Tokoro0917/KOGUMA-Mk4/mechanical/sensor_holder/README.md

# 壁センサのホルダ(v4、2026-11-01)

発光(OPV332)と受光(SFH 229 FA)を入れて、**基板の裏(下)にさかさまに付ける**樹脂の部品。4個(FL・FR・L・R)。**ToraNeko.Mk3 のセンサホルダ v4 と同じ形**(`mechanical/exported/TORANEKO.Mk3_v36.step` の「センサホルダ v4」を CadQuery で読んで測った)。

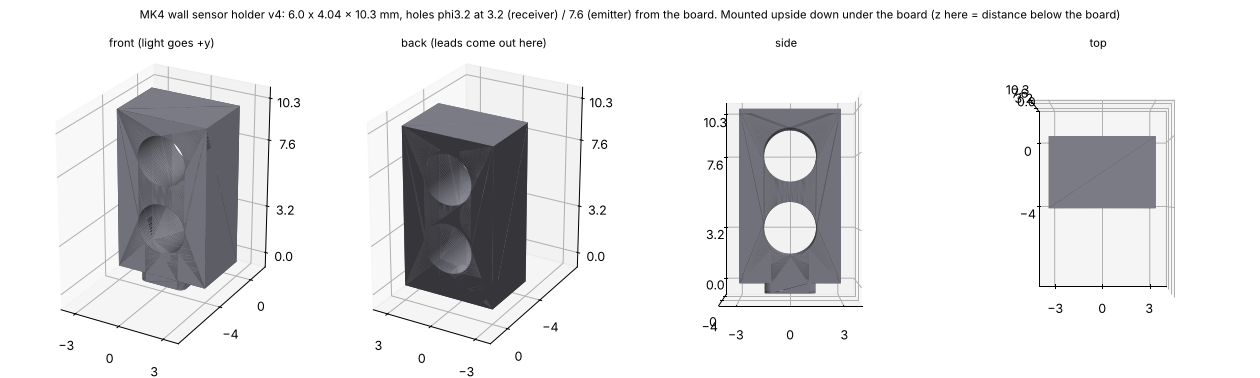
[picture p4: mechanical/sensor_holder/sensor_holder_v4.png]
センサのホルダ


図の z は基板の面からの距離(機体では下向き)。

| 項目 | 寸法 |
|---|---|
| 大きさ | 幅 6.0 × 奥行き 4.04 × 高さ 10.3mm(基板の下面 z 13.6 から下の端 z 3.3。フレームの上面 z 3.0 との 0.3mm に両面テープをはさんで当てる) |
| 下の端 | 平らな 6.0 × 4.04mm(24mm²)。緩衝材(両面テープ)を貼ってフレームに当てる(v4) |
| 穴 | φ3.2 を光の向きに貫通。**基板から 7.6mm(z 6.0)が発光 OPV332、3.2mm(z 10.4)が受光 SFH 229 FA**(どちらも φ3 の T-1)。ToraNeko と同じく、発光が基板から遠い穴 |
| 角 | すべて角(v4。v3 までは前の縦の辺 R1.6、前の端の辺 R1.6、端の横の辺 R1.0) |
| ほぞ | 3.0 × 3.0 × 0.6mm(基板の厚さ)、角 R0.4。後ろの面にそろえる。基板の穴は 3.2 × 3.2mm、角 R0.5 |
| 重さ | 190mm³、約0.22g(光造形の樹脂 1.15 g/cm³) |

**v4(2026-11-01)**: **後ろへ出す足をやめ、ホルダの形のまま、そのまま下まで伸ばす**(四角い柱 6.0 × 4.04 × 10.3mm)。**丸めていた角をすべて角にし**、下の端の面を全部平ら(6.0 × 4.04mm = 24mm²)にして、そこに**緩衝材(両面テープ、スポンジ)**を貼ってフレームに当てる。
- フレーム v6.9 は、この下の端の真下とまわり 1mm を窓のないカーボンにした(4つとも 24.2mm² がすべてカーボン)
- 発光・受光の足、基板のパッドの位置は v3 と同じ

**v3(2026-10-31)**: **下の端をフレームに当てる**。v2 はフレームとの間が 0.7mm で、フレームの前がたわむ(前の角に 1.5N で 0.56mm)と当たるおそれがあった。逆にフレームに当てて、基板の前の板をフレームで支える。
- 高さ 9.9 → 10.3mm(下の端 z 3.3)。フレームとの 0.3mm に**両面テープ(スポンジ)**をはさんで貼る。印刷の誤差(±0.2mm)を吸い、衝撃をやわらげる。光の高さ(穴の位置)は v2 と同じ
- 下の端から後ろへ足(3.5mm)を出す。横の2本は真下がほとんどフレームの窓なので、足で後ろの骨に当てる
- 基板の振動(`mechanical/vehicle/pcb_modes.py 0.6 holders`): 横の壁センサが揺れる振動は、v2(当てない)の 148Hz から、ホルダの所で固く支えるとなくなる(基板の一番低い振動は電池の下で 289Hz)。テープはやわらかいのでこれより下がるが、センサはフレームと一緒に動くようになる(フレームの1次は 262Hz)
- 基板を外すときは、テープをはがす
- フレームは v6.7 で、ホルダ(足を含む)の真下とまわり 1mm を窓のないカーボンにした(当てる所 45mm²)

**v2(2026-10-30)**: 基板の裏に付けることにしたので、ToraNeko と同じ高さ 10.5mm(穴 3.5・8.1mm)ではフレームまで 0.1mm しかない。高さを 9.9mm、穴を 3.2・7.6mm(穴の間の壁 1.2mm、端の壁 0.7mm)にした。v1 は基板の上に立てる ToraNeko と同じ寸法だった

機体(`mechanical/vehicle/vehicle.py`)で確かめた: ほかの部品とぶつからない(v3・v4 はフレームと 0.3mm で、そこに両面テープ)。光(前の面から 60mm、広がりを見て円すい)を遮る部品はない

- **光を通さない黒い樹脂**で作る(JLC3DP の光造形、**JLC Black Resin**。2026-10-31)。発光の光がホルダの中を通って受光に入らないようにする(ToraNeko の README:「LED からの光が隣の受光素子に直接入らないよう、センサホルダで遮光する」)
- 発光・受光は後ろから穴に差し、足を後ろの面で基板の側(上)に曲げて基板の穴に通し、基板の上の面ではんだ付けする。受光(下)の足は後ろの面の 0.85mm 後ろ、発光(上)の足は 3.0mm 後ろ(ToraNeko は 2.8mm。基板のパッドどうしを離すため少し後ろにした)。足のピッチは 2.54mm
- 穴の φ3.2 は ToraNeko と同じ。OPV332 の外径は販売店の資料で 3.18mm なので、きつければ φ3.2 のドリルでさらう。ゆるければ接着する
- 基板への付け方: ほぞを下から基板の穴に差して、足を上からはんだ付けする。ホルダは足でつり下がるので、基板の裏に接着もする
- 基板の側: フットプリント `KOGUMA-Mk4:WallSensor_Holder_Emitter`(ほぞの穴を Edge.Cuts で含む)と `WallSensor_Holder_Receiver` を、**裏の面に**、同じ位置・同じ向き(光の向き)に置く。位置は `mechanical/vehicle/pcb_shape.py` の `SENS`(ホルダの前の面の真ん中)

| ファイル | 中身 |
|---|---|
| `sensor_holder.py` | CadQuery のスクリプト。寸法は `P` |
| `sensor_holder_v3.step`・`.stl` | 注文用(単位 mm) |
| `sensor_holder_v4.png` | 図 |

作り直すには(このフォルダで): `python3 sensor_holder.py`
