Tokoro0917/KOGUMA-Mk4/docs/reference/README.md

# 参考資料

| ファイル | 中身 |
|---|---|
| `KOGUMA-CHAN.MkII_v2.pdf` | MK3(KOGUMA MkIIl)の回路図(KiCad、A3、1枚)。MK4 の資料で「MK3 と同じ」と書いた回路(壁センサ、電源スイッチ、ファン、LED、ブザー、スイッチ、発振子など)の元 |
