Tokoro0917/KOGUMA-Mk4/hardware/kicad/KOGUMA-Mk4_Encoder/README.md

# KOGUMA-Mk4_Encoder(エンコーダの基板)

KiCad 9.0 で開く(`KOGUMA-Mk4_Encoder.kicad_pro`)。左右で同じ基板を2枚使う。

| ファイル | 中身 |
|---|---|
| `KOGUMA-Mk4_Encoder.kicad_sch` | 回路図: MT6835、C1(0.1µF)、J1(メイン基板へのパッド7つ) |
| `KOGUMA-Mk4_Encoder.kicad_pcb` | 基板: 5.3 × 12.3 × 0.6mm、2層。MT6835 はチップの面(F)、C1 は裏の面(B) |
| `KOGUMA-Mk4_Encoder.kicad_sym` | MT6835 の記号(KiCad の標準ライブラリにないので作った。ピンはデータシート Rev.1.3 の表) |
| `KOGUMA-Mk4_Encoder.pretty/ENC_Edge` | 基板の上の辺のパッド。`Dwgs.User` にメイン基板の上下の面、磁石の軸、マウントのくぼみ、下の辺を描いてある |
| `KOGUMA-Mk4_Encoder.pretty/TSSOP-16_4.4x5mm_P0.65mm_Pad0.35` | KiCad の TSSOP-16 のパッドの幅を 0.4 → 0.35mm にしたもの(1・8・9・16番と基板の縁を 0.2mm 離すため) |

メイン基板の側のフットプリントは `../KOGUMA-Mk4/KOGUMA-Mk4.pretty/ENC_Base_Slot`(J5・J6)。番号は J1 と同じ。

## 置き方(モーターマウント v9)

- メイン基板(0.6mm、z 13.6〜14.2)の穴(NPTH 1.0 × 5.9mm)に下から通し、上に 1.4mm 出た所を、メイン基板の上で両面からはんだ付けする。机の上で付けてから、メイン基板ごとマウントに載せる
- 基板は z 3.3〜15.6(下の辺はフレームから 0.3mm 浮く)、x −2.65〜2.65(x 0 が車軸の真上)。チップの面(F)は外(磁石の側)を向き、マウントの面と 0.1mm
- MT6835 の中心は x 0、z 7.5(上の辺から 8.1mm)。IC と磁石のすき間は 0.5mm
- チップの面の部品はマウントのくぼみ(z 3.8〜11.3)の中だけ。くぼみより上は線だけ。裏の面(B、内側)は開いているので C1 を置く
- 左右で同じ基板。右は 180° 回した向きで付ける(メイン基板の J6 を 180° 回して置く)

## J1(上の辺から 0.2〜2.0mm)

| 番号 | ネット | 面 | 幅 |
|---|---|---|---|
| 1 | +3V3 | 裏(B) | 2.2mm |
| 2 | ENC_CAL(CAL_EN) | チップの面(F) | 0.6mm |
| 3 | ENC_MISO | チップの面(F) | 0.6mm |
| 4 | ENC_MOSI | チップの面(F) | 0.6mm |
| 5 | ENC_SCK | チップの面(F) | 0.6mm |
| 6 | ENC_CS | チップの面(F) | 0.6mm |
| 7 | GND | 裏(B) | 2.2mm |

チップの面のパッドのピッチは 1.0mm(すき間 0.4mm)。

## 回路と配線

- MT6835 は 180° 回し、SPI と CAL_EN のある辺(1〜8番)を上に向けた。5本はチップの面をまっすぐ上のパッドへ
- VDD(9)・VSS(12)は IC の下のビアで裏に移り、C1(0.1µF、0402)を通って上の 3.3V・GND のパッドへ
- TEST(11)・TEST_EN(13)は GND(データシートの図5・6)。U・V・W・A・B・Z・OUT は使わない
- CAL_EN(4)は中に 250kΩ のプルダウンがあり、ふだんは L。校正のときにメイン基板の PC15 で H にする
- TVS(データシートの推奨)は場所がないので付けない

## 確かめたこと(2026-10-29、kicad-cli 9.0.9)

- ERC: エラー 0(警告は、確かめた環境に KiCad の標準ライブラリが登録されていないことによるものだけ)
- DRC: エラー 0、つながっていないパッド 0、回路図と基板の食い違い 0。ルールは ToraNeko.Mk3 と同じ(クリアランス 0.2mm、ビア 0.6/0.3mm、穴と穴 0.25mm、縁まで 0.2mm)

## まだ決めていないこと

- 面付け(1枚が小さいので、何枚かつないで注文する。ToraNeko.Mk3 の `panel/` を参考に)
- メイン基板を 0.8mm にするなら、上に出る長さが 1.2mm になる(パッドはそのままで足りる)
- 直角の出し方(はんだ付けのときの治具)
