Tokoro0917/KOGUMA-Mk4/docs/img/mount/mount_v1_sections.png

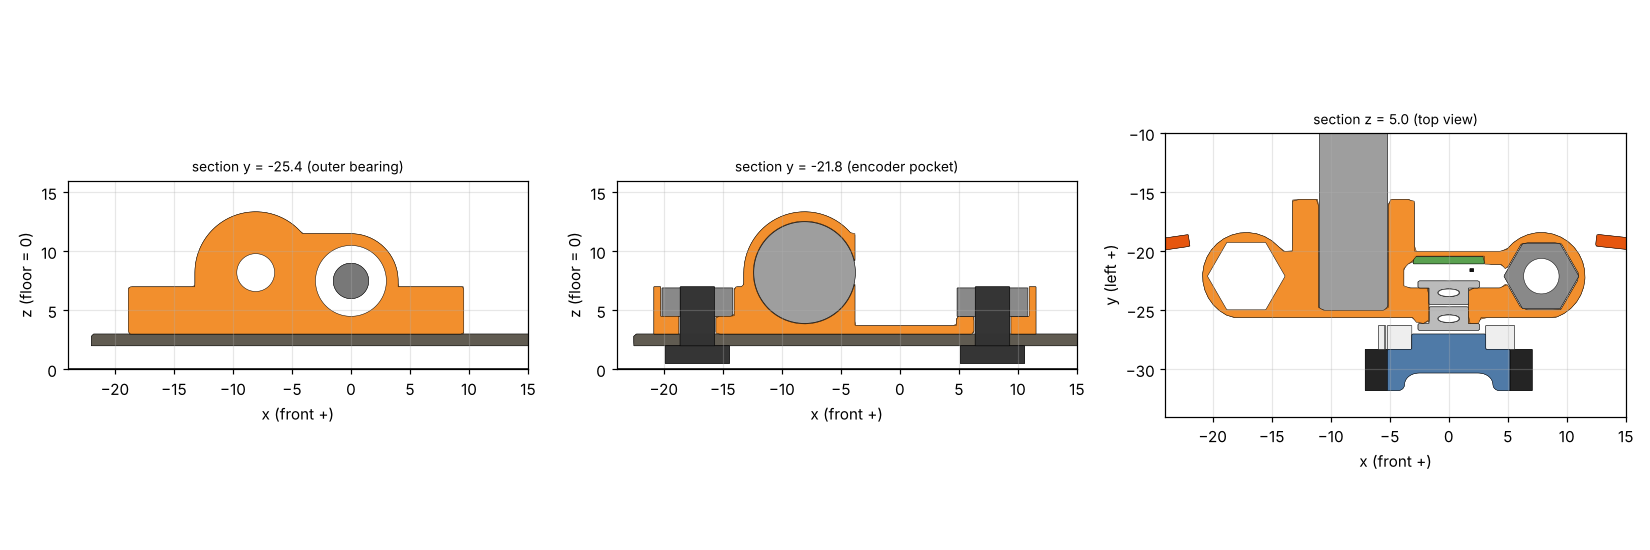
docs/img/mount/mount_v1_sections.png
