Tokoro0917/KOGUMA-Mk4/docs/img/vehicle/pcb_modes_v6_0.6_mass.png

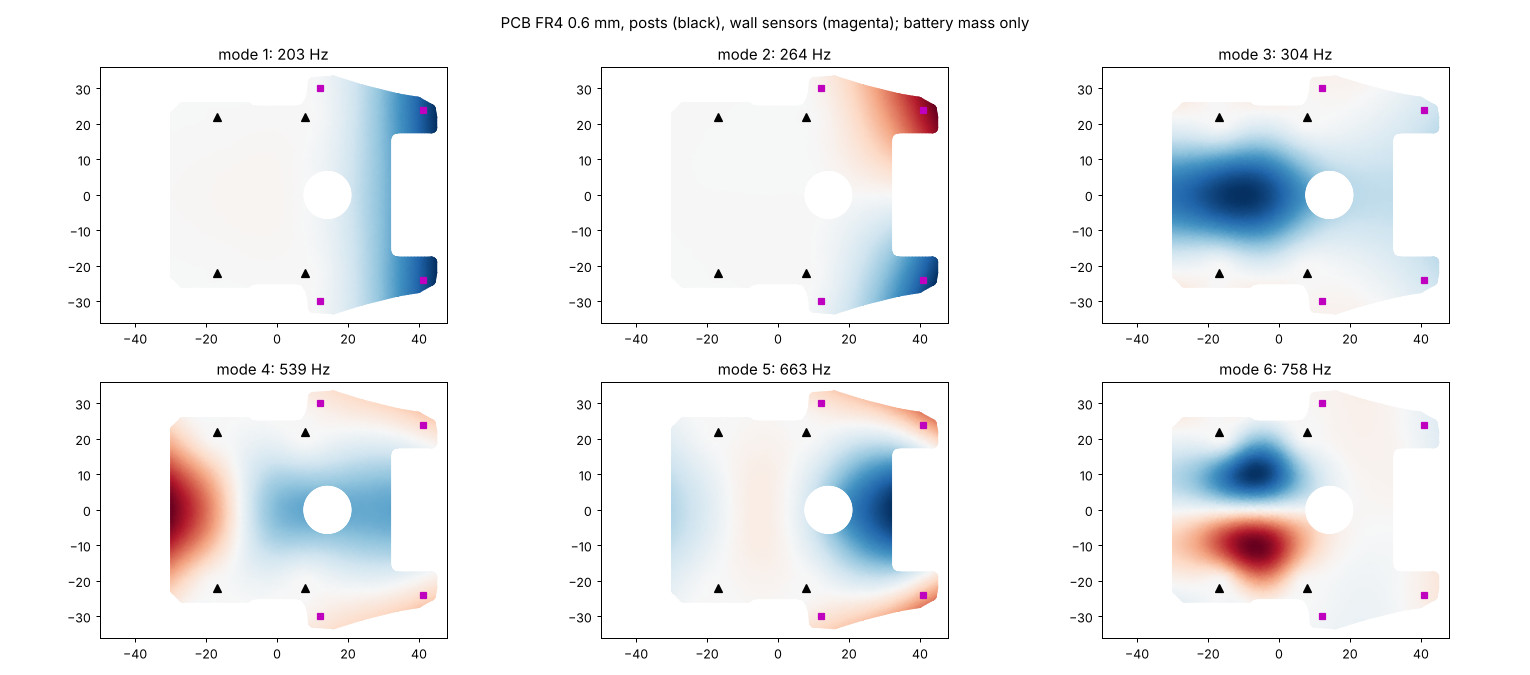
docs/img/vehicle/pcb_modes_v6_0.6_mass.png
