Tokoro0917/KOGUMA-Mk4/docs/img/vehicle/pcb_modes_v10_0.6_mass.png

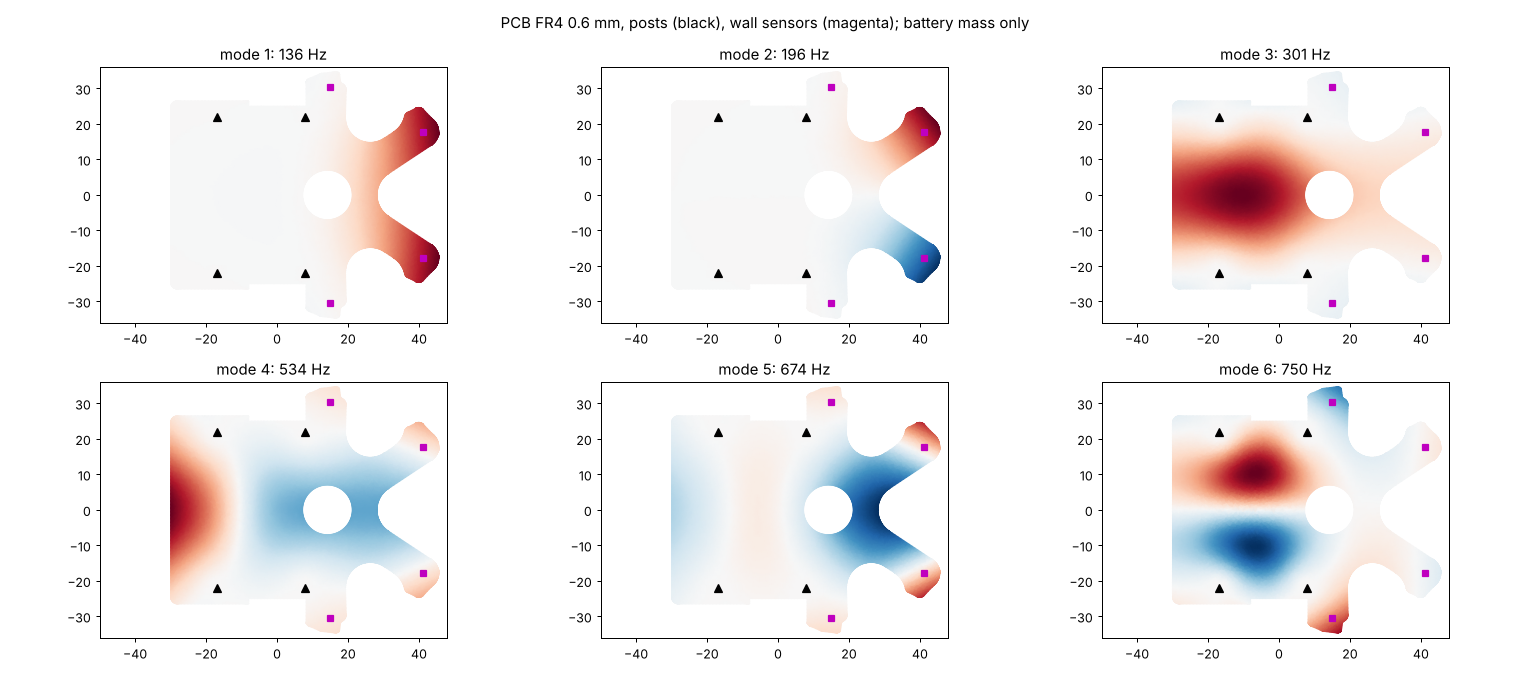
docs/img/vehicle/pcb_modes_v10_0.6_mass.png
