Tokoro0917/KOGUMA-Mk4/docs/img/vehicle/pcb_modes_v16_0.6_holders_mass.png

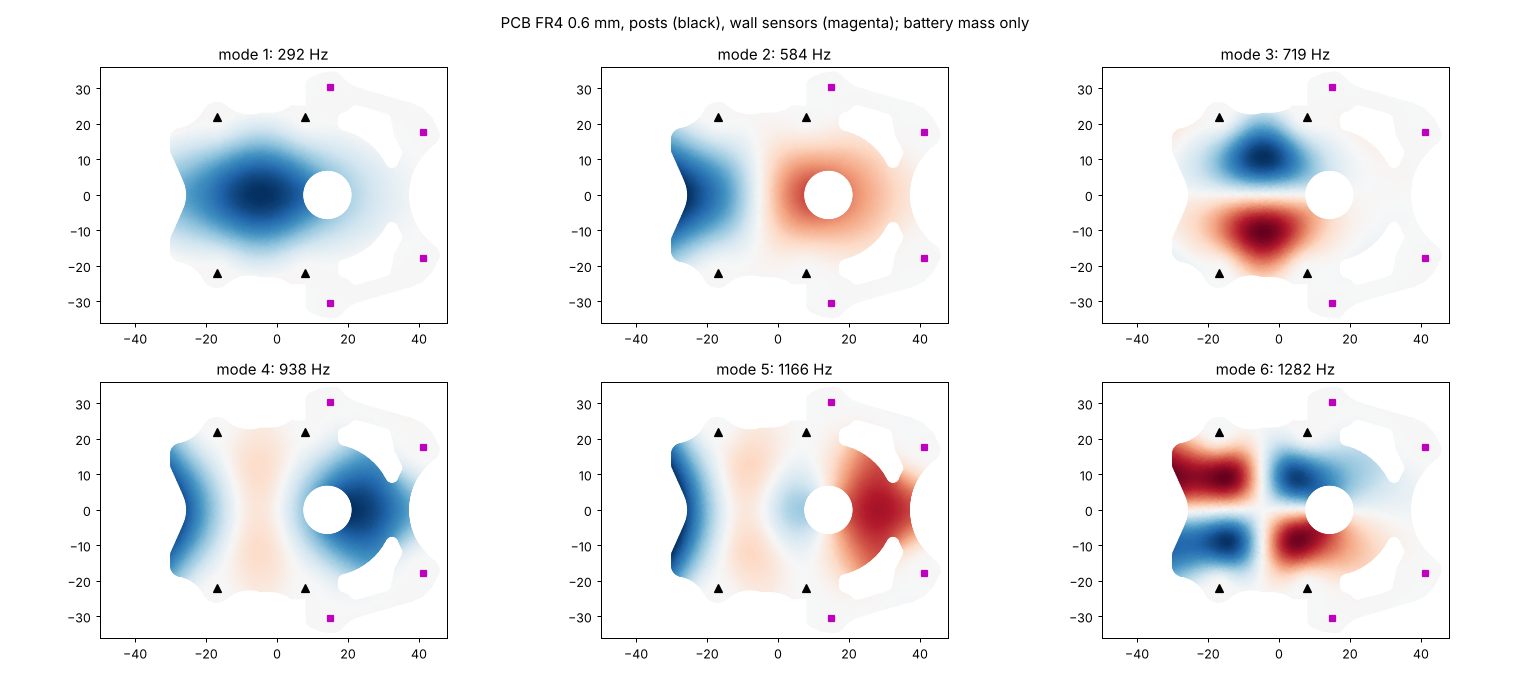
docs/img/vehicle/pcb_modes_v16_0.6_holders_mass.png
