Tokoro0917/KOGUMA-Mk4/docs/img/vehicle/pcb_u.png

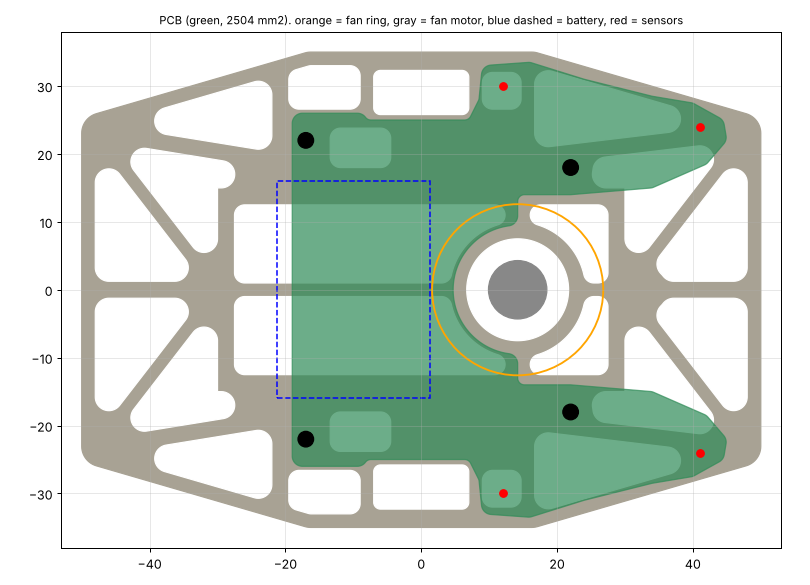
docs/img/vehicle/pcb_u.png
