Tokoro0917/KOGUMA-Mk4/docs/img/vehicle/sensor_beams_diag.png

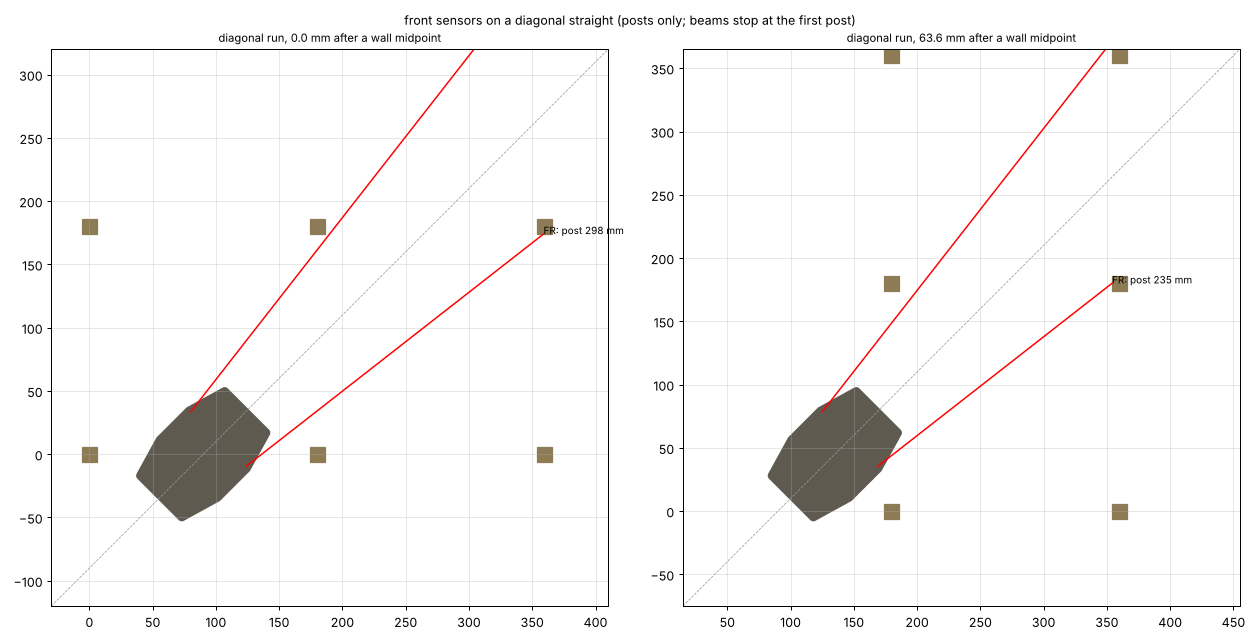
docs/img/vehicle/sensor_beams_diag.png
