Tokoro0917/KOGUMA-Mk4/docs/img/vehicle/vehicle_v4_views.png

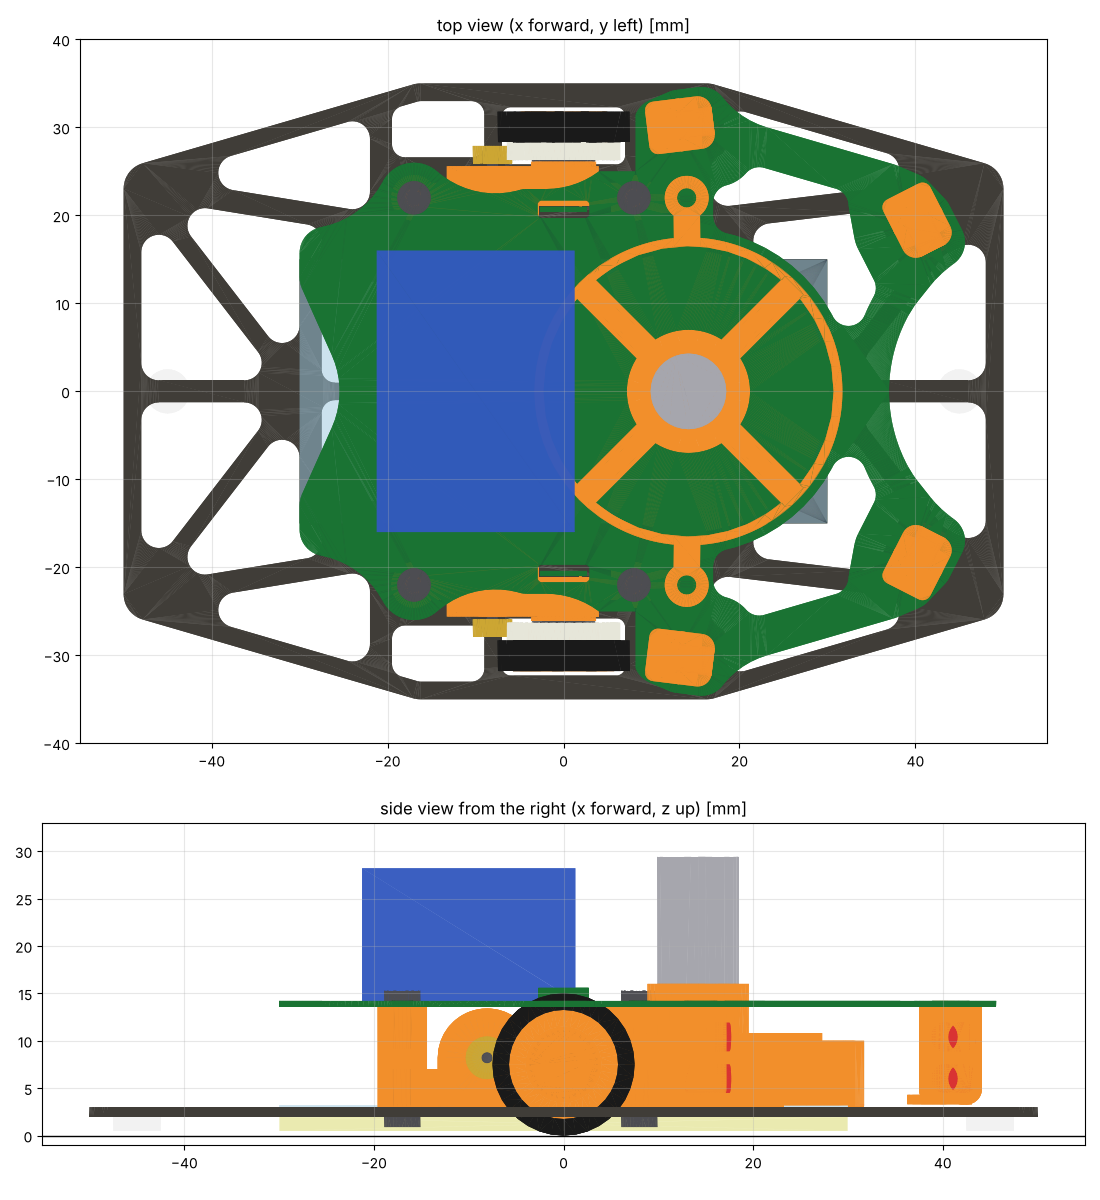
docs/img/vehicle/vehicle_v4_views.png
