Tokoro0917/KOGUMA-Mk4/mechanical/pcb/pcb_outline_v6.png

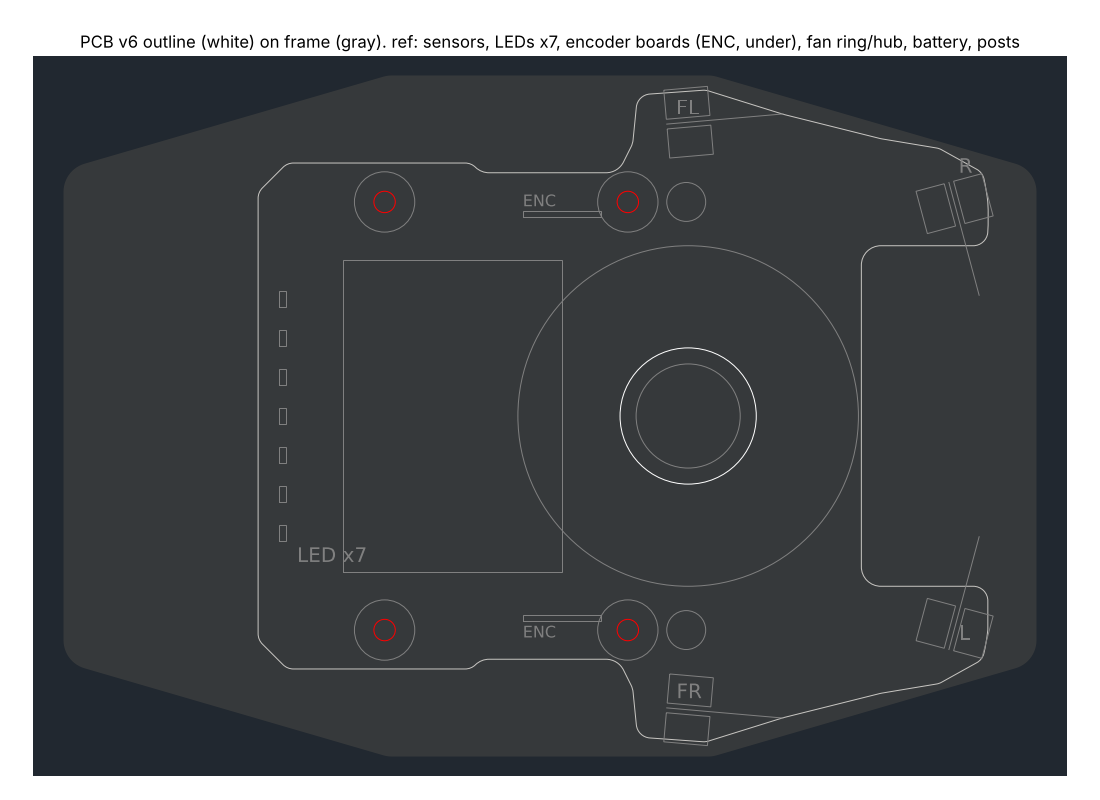
mechanical/pcb/pcb_outline_v6.png
