Tokoro0917/KOGUMA-Mk4/mechanical/pcb/pcb_outline_v7.png

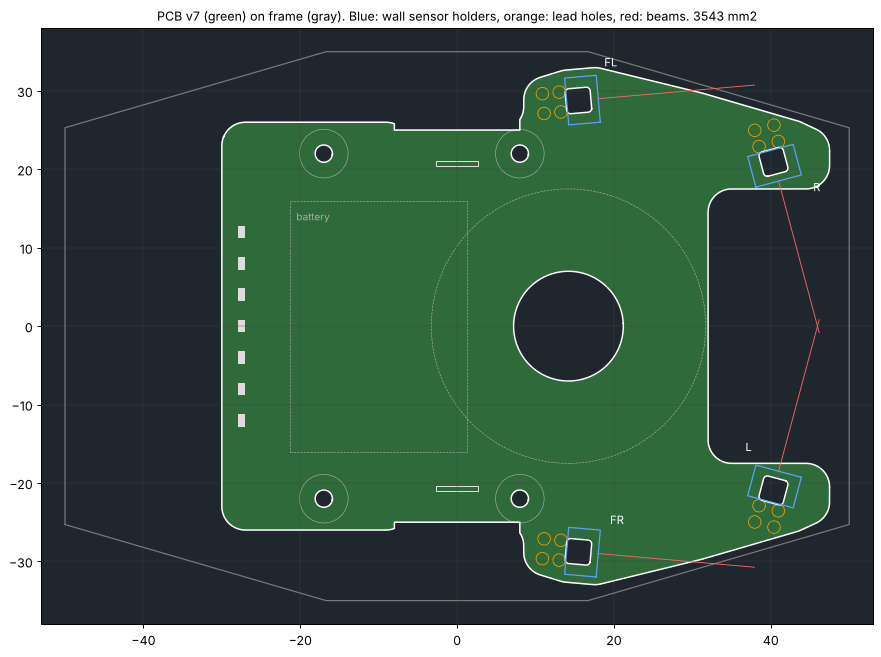
mechanical/pcb/pcb_outline_v7.png
