Tokoro0917/KOGUMA-Mk4/mechanical/vehicle/vehicle_v4_views.png

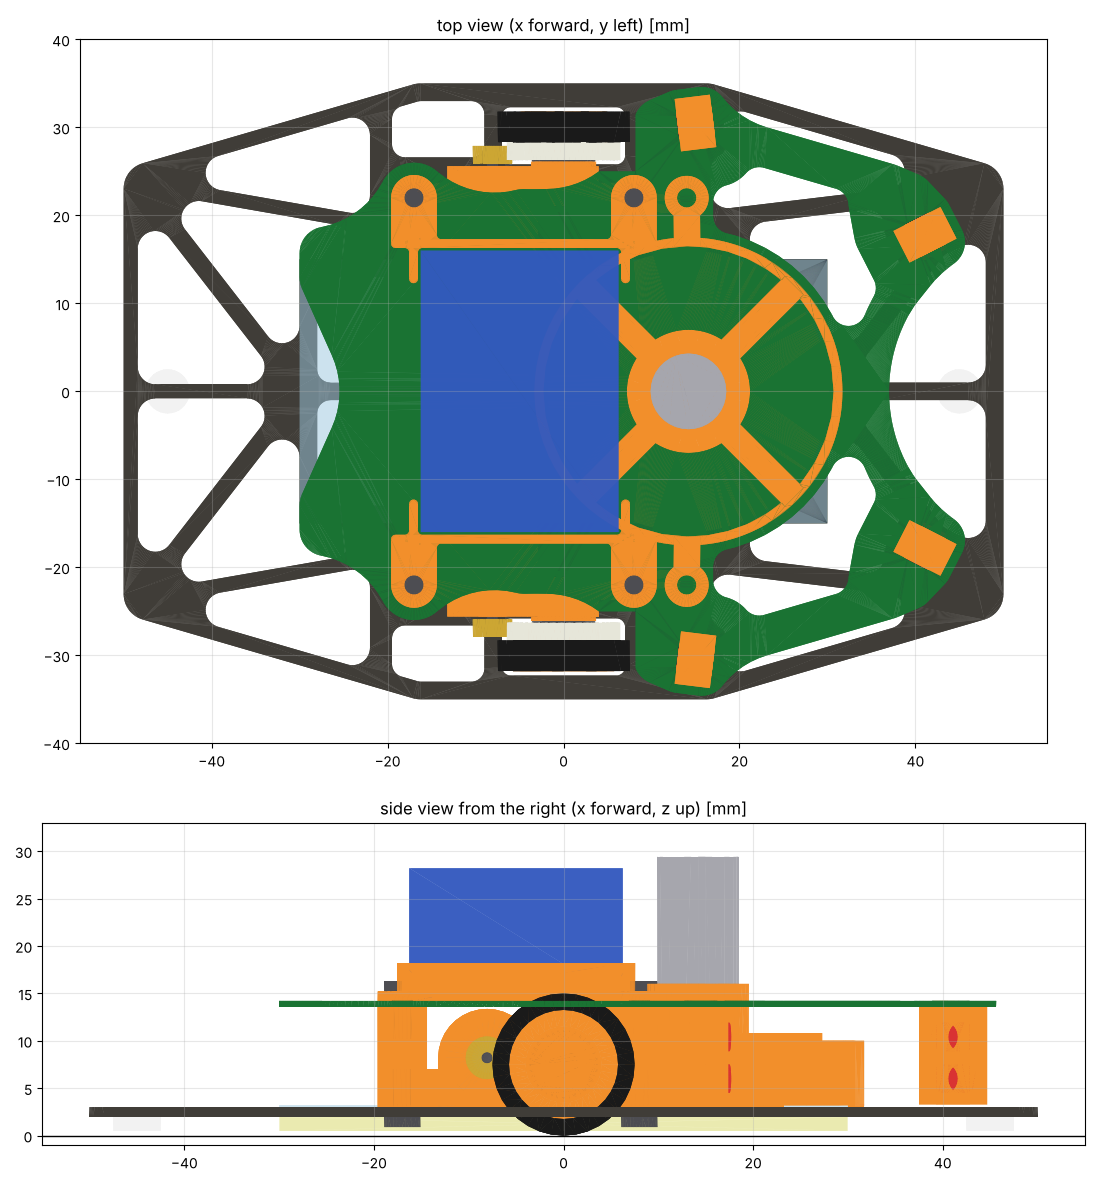
mechanical/vehicle/vehicle_v4_views.png
