Tokoro0917/KOGUMA-Mk4/docs/order.md

# MK4 機械部品の注文一覧

2026-10-30作成。機械の部品(フレーム・印刷する部品・足回り・ねじ)を注文先ごとにまとめた。回路の部品は`docs/bom.md`の「2.」から。数は、予備を含めた案。

**一番先に頼むもの: モーター**(受注生産で約4週間かかる)

## 1. モーター

| 品番 | 数 | メモ |
|---|---|---|
| NFP-D8620-3665-3-7.4(7.4V版、8.6 × 20mm、5.3g、軸径1.2mm) | **4**(走行用2、ファン用1、予備1) | 受注生産で約4週間。購入先は前と同じ所 |

## 2. カーボンラボ.jp(フレーム)

見積もりのフォーム: <https://cfrp-japan.com/order-board-data/>

| 項目 | 内容 |
|---|---|
| ファイル | `mechanical/frame/MK4FRAME69_T1.dxf`(frame v6.9、1:1、単位 mm) |
| 厚さ・材料 | 1mm、綾織・クロス・マット |
| 数 | 2枚(1枚は予備) |
| 備考に書くこと | 「繊維の向きは図の X 方向(前後)を 0°に」 |

## 3. JLC3DP(印刷する部品)

すべて光造形(SLA)で、1回の注文にまとめる。材料は2つに分ける(2026-10-31):

- **モーターに付く部品(モーターマウント・ファンの台)は JLC Temp Resin**(荷重たわみ温度 101°C、精度 ±0.2mm / 100mm、すすめる壁 0.8mm 以上、色は薄い黄色)。モーターの熱で圧入・軸受の穴がゆるまないように
- **ほかの部品(ホイール・壁センサのホルダ・電池のホルダ)は JLC Black Resin**(黒、荷重たわみ温度 54〜65°C)。熱はかからない。ホルダは光を通さないため黒が要る

MJF の PA12(熱に強く黒く染められる)は、精度 ±0.3mm・すすめる壁 1.0mm で、マウントの壁 0.8mm・ギアのかみ合い・羽根と輪のすき間 0.5mm に合わないので使わない。

| 部品 | ファイル | 材料 | 数 | 1個の重さ |
|---|---|---|---|---|
| モーターマウント v11(右) | `mechanical/motor_mount/motor_mount_R_v11.stl` | Temp Resin | 3 | 1.28g |
| モーターマウント v11(左) | `mechanical/motor_mount/motor_mount_L_v11.stl` | Temp Resin | 3 | 1.28g |
| ファンの台 v1 | `mechanical/fan_mount/fan_mount_v1.stl` | Temp Resin | 3 | 1.64g |
| ホイール v1(右) | `mechanical/wheel/wheel_R_v1.stl` | Black Resin | 3 | 0.38g |
| ホイール v1(左) | `mechanical/wheel/wheel_L_v1.stl` | Black Resin | 3 | 0.38g |
| 壁センサのホルダ v4 | `mechanical/sensor_holder/sensor_holder_v4.stl` | Black Resin | 6(4 + 予備2) | 0.22g |
| 電池のホルダ v1(左) | `mechanical/battery_holder/battery_holder_L_v1.stl` | Black Resin | 2 | 0.23g |
| 電池のホルダ v1(右) | `mechanical/battery_holder/battery_holder_R_v1.stl` | Black Resin | 2 | 0.23g |

- 仕上げは標準(色付け・研磨なし)
- 備考に書くこと: 「φ1.6 の穴はあとでタップを立てるので、ふさがないでください」「穴のまわりの細い当たり面は削らないでください」
- モーターマウント v11 のモーターの穴(当たり面 φ8.5)と軸受の穴(当たり面 φ5.9)は、わざと寸法より 0.1mm 小さくしてある(しまりばめ)。備考に「モーターと軸受の穴は圧入用に小さくしてあります」と書く
- JLC3DP は M6 未満のねじ山を作らないので、M2 は届いてから自分でタップを立てる(`docs/mount.md`の「7. 注文」)

## 4. 吸引ファンの羽根

**羽根は自分で用意する**(2026-11-01。ここでは注文しない)。ファンの台は「羽根 φ32、羽根の上面 z 8.0、輪とのすき間 半径0.5mm」として作ってある(`mechanical/fan_mount/README.md`)。寸法が違うときは、ファンの台を直す。

## 5. 足回りの部品

| 部品 | 品番・仕様 | 数 | メモ |
|---|---|---|---|
| 軸受 | LF-630(内径3mm、外径6mm、つば付き) | 6(4 + 予備2) | ToraNeko.Mk3 と同じ |
| 車軸 | 3 × 6 の平行ピン | 4(2 + 予備2) | ToraNeko.Mk3 と同じ |
| エンコーダの磁石 | φ3 × 1mm、直径方向に着磁 | 4(2 + 予備2) | ToraNeko.Mk3 と同じ |
| ピニオン | m0.3、13T、軸径1.2mm 用 | 4(2 + 予備2) | 自分で入手(`docs/spec.md`の「ピニオンの入手」) |
| スパー | 41T、m0.3 | 2 | **手持ち**。材質・内径・厚さを測る |
| タイヤ | ミニッツのタイヤ、直径15mm | 4(2 + 予備2) | ホイールは **内径 φ11.5・幅3.5mm** として作ってある。届いたら測る |

## 6. ねじ・工具

| 部品 | 数 | 使う所 |
|---|---|---|
| **鉄 低頭小ねじ M2 L5**(頭 φ3.8 × 1.1mm、頭の高さ1.5mm以下)。**ねじはこの1種類だけ**(2026-10-30) | 10 + 予備 | フレームの下から、マウントの前後の耳へ(4)。基板をマウントの前後の柱へ(4)。ファンの台をマウントの腕へ(継ぎ目 (14, ±22)、2) |
| M2 × 0.4 のハンドタップ | 1 | 印刷の部品のねじ穴(マウント1個に3つの穴、上下から) |
| φ1.6 のドリルとピンバイス | 1 | 下穴が細いときに通す |
| 瞬間接着剤 | 1 | 41T をホイールに、磁石を平行ピンに。圧入がゆるいとき。壁センサのホルダを基板の裏に |
| 両面テープ(スポンジ、厚さ 0.3mm 前後) | 1 | 壁センサのホルダの下の端に貼って、フレームに当てる緩衝材(ホルダ v4)。電池の底を基板に貼る(電池のホルダ) |

## 7. その他

| 部品 | 数 | メモ |
|---|---|---|
| 硬質塩ビ 0.2mm | 1枚 | `mechanical/frame/MK4PC69_template_A4_1to1.pdf` を「実際のサイズ」で印刷して型にし、カッターで切る(または`MK4PC69_T02.dxf`をレーザー加工に出す) |
| カグスベール(ニチアス、フリーサイズ、約1.5mm) | 1枚 | φ5 に切って、フレームの下(x = ±45)に貼る |
| スカートのフィルム 0.1mm | 1枚 | **材料は未定**(PET などの案) |
| 電池 LiPo 3S 180mAh 45C | 1〜2 | **品番は未定**。軽いもの(12.5g級)を探す |

## 届いたら

- モーターマウント: `docs/mount.md`の「7. 注文」の「届いたら」(割れ・欠けを見る、タップ、軸受とモーターの圧入、かみ合いの確認)
- ファンの台・羽根: 羽根と輪のすき間(半径0.5mm)を回して確かめる。羽根の振れを見る
- ホイール: タイヤの内径と幅を測る
- 組んだら、吸引力・ファンの電流・ファンのモーターの温度・滑り出す力(μ)を測る
