Tokoro0917/KOGUMA-Mk4/docs/bom.md

# MK4 部品表(案)

2026-10-12作成。回路図を描き始めるための一覧。ピンの割り当ては`docs/pinmap.md`、決めた理由は`docs/spec.md`。

「根拠」の列: **DS** = データシートの値、**MK3** = MK3(KOGUMA-CHAN.MkIIの回路図)と同じ、**仮** = 仮の値で、回路図を描くときに決める、**要選定** = 品番をこれから決める。

## 1. 駆動・機構

| 部品 | 品番・仕様 | 数 | 根拠・メモ |
|---|---|---|---|
| 走行用モーター | NFP-D8620-3665-3-7.4(7.4V版、8.6×20mm、5.3g、軸径1.2mm) | 2 | 決定。受注生産で約4週間 |
| ファン用モーター | 同上 | 1 | 走行用と同じ予定(要確認) |
| スパーギア | 41T(m0.3、歯先12.9mm。手持ちの余り) | 2 | 決定(2026-10-17に38Tから変更)。材質・内径・厚さは測って書く |
| ピニオン | m0.3、**13T**(ギア比3.15、軸間8.10mm)、軸径1.2mm用 | 2 | 決定(2026-10-17に11Tから変更。11Tではモーターが軸受と当たる)。自分で入手 |
| エンコーダの磁石 | φ3、直径方向に着磁(ToraNeko.Mk3と同じもの) | 2 | 車軸(3×6の平行ピン)の端に付ける |
| タイヤ | ミニッツのタイヤ、直径15mm(ToraNeko.Mk3は14mm) | 2 | スパー41T(歯先12.9mm)で床まで約1.05mm。15mmにできるか確かめる |
| ホイール | ToraNeko.Mk3と同じ形(`mechanical/wheel/`、wheel v1、外径 φ11.5、1個0.38g)。JLC3DP の光造形、JLC Black Resin(2026-10-31。モーターに付く部品だけ Temp Resin) | 2 | タイヤの内径 φ11.5・幅3.5mm として作ってある。15mm のタイヤの内径を測って確かめる |
| 車軸 | 3×6の平行ピン | 2 | ToraNeko.Mk3と同じ |
| 軸受 | LF-630(内径3mm、外径6mm) | 4 | ToraNeko.Mk3と同じ(片側2個) |
| モーターマウント | v9(ねじ山を切る、前の耳から腕を出して (14, ±22) でファンの台を持つ、1個1.29g。穴は3点で受ける。エンコーダ基板は面に貼る。`docs/mount.md`。M2、後ろの耳に基板を受ける柱。ねじの位置はフレーム v6.1 に合わせて1mm単位)。JLC3DPの光造形、JLC Temp Resin(注文と後の加工は`docs/mount.md`の「7. 注文」)。STLは`mechanical/motor_mount/` | 2(左右) | 軸受φ6.0は圧入、モーターφ8.7は接着。モーターの軸は前の面から2.9mmで切る |
| 吸引ファンの羽根・ダクト | 自作(**羽根φ32、囲いの内径φ33**、2026-10-20)。**羽根は自分で用意する**(2026-11-01。ファンの台は JLC Temp Resin) | 1 | 設計する。機体の仮の案 v4(`docs/vehicle.md`)では、羽根φ32のまわりを輪(内側φ33)で囲い、斜め45°の4本の腕でモーターの受けを輪につなぐ台(樹脂)を、モーターマウントの腕 (14, ±22) にナイロンのM2 × 2本で留める(フレームには留めない。輪の壁1.0mm)。ファンの真下はフレームのカーボンで埋め、吸い込みは真ん中のφ15から。モーターはハブの筒(穴φ8.6)に圧入する |
| 滑り板 | カグスベール(ニチアス、フリーサイズ 100 × 120mm、約1.5mm)をφ5に切る | 2 | 背骨の下(x = ±45)に直接貼る(床とのすき間 約0.5mm)。前の角は丸める。`docs/spec.md`の「段差と滑り板」 |
| スカート | 0.1mmのフィルム(仮) | 1式 | 吸引する面の縁、床から0.5mm |
| ねじ | **M2、鉄 低頭小ねじ L5 の1種類だけ**(2026-10-30。頭 φ3.8 × 1.1mm)。フレームの下から、マウントの前後の耳へ4本。基板をマウントの前後の柱へ上から4本。ファンの台をマウントの腕(継ぎ目 (14, ±22))へ上から2本。**印刷の部品は下穴φ1.6にM2のねじ山を切る(タップ)**。フレーム・基板・ファンの台の通し穴はφ2.2 | 10 | 約2.2g(モデル。1本約0.2g)。ナイロンを混ぜていたとき(1.1g)より +1.1g。チタンの低頭 L5 にすれば約 −1g。エンコーダの磁石からは 8mm 以上離れている |
| 電池 | LiPo 3S 180mAh 45C(最大8.1A)。**1S 180mAhを3個立てて並べ、自分で直列にする**(2026-10-28決定) | 1S × 3 | 決定。8A程度流れることがある。品番が決まったら重さとセルの内部抵抗を量る。機体の仮の案では1S(7.5 × 32 × 14mm)× 3を立てて並べた形、14.5g(50gにするには12.5g級)。**電池の側でタブをはんだ付けして直列にし、電源のコネクタ1個 + バランス端子にまとめる**(2026-10-29決定。10-28 の「基板の上で直列」から変更)。充電は3S用のバランス充電器(これから買う)。`docs/spec.md`の「電池のつなぎ方と電源の経路」 |

## 2. MCU

| 部品 | 品番・仕様 | 数 | 根拠・メモ |
|---|---|---|---|
| MCU | STM32H725RGV6(−40〜85°C)またはRGV3(−40〜125°C)、VFQFPN68 | 1 | 決定。在庫を見て選ぶ。リフローで付ける |
| SMPSのインダクタ | **村田 DFE201610E-2R2M(P2)**: 2.2µH、2.0×1.6×1.0mm、直流抵抗140mΩ以下、飽和電流1.9A、定格電流1.7A(販売店の値) | 1 | 条件はDS(表16): 2.2µH、直流抵抗150mΩ以下、飽和電流1.7A以上、定格電流1.4A以上。村田のデータシートで飽和電流の定義(30%低下)を確かめる |
| VDDSMPSのコンデンサ | 4.7µF(ESR 100mΩ以下) | 1 | DS(表16) |
| VFBSMPSのコンデンサ | 10µF(ESR 20mΩ以下) | 1 | DS(表16) |
| VLXSMPSのコンデンサ | 220pF | 1 | DS(表16) |
| VCAPのコンデンサ | **100nF**。VCAPは3本あるが、コンデンサは2個(3本ともVCOREにつなぐ) | 2 | DS(表15の注1: レギュレータ(LDO)を使わないときは2.2µF × 2 は要らず、100nF × 2 に替える)。VFQFPN68はDirect SMPS専用でLDOを使わないので、こちら(2026-10-29。それまでは2.2µF × 2)。VCOREの出力のコンデンサはVFBSMPSの10µF |
| VDDのパスコン | 100nF(VDDピンごと)+ 4.7µF 1個 | 5 + 1 | 仮。AN5419で数と値を確かめる |
| VDDAのコンデンサ | 1µF + 100nF、3.3VとVDDAの間にフェライトビーズ(BLM18PG221 など、仮) | 各1 | 仮。MK3もVDDAに1µF + 100nF。VFQFPN68はVREF+がなく、ADCの基準はVDDA。フェライトビーズは2026-10-29に足した(SMPS・モーターのノイズをADCから離す) |
| VBAT | VDDにつなぎ、100nF | 1 | 仮 |
| BOOT0 | 10kΩでGNDへ | 1 | 仮 |
| NRST | 100nF | 1 | 仮 |
| 発振子(HSE) | **村田 CSTNE10M0G52Z000R0**(セラミック発振子、10MHz、3.2 × 1.3mm、3端子、負荷容量10pFを内蔵)。MK3(`docs/reference/KOGUMA-CHAN.MkII_v2.pdf` の Y1)と同じ | 1 | 2026-10-29決定(それまでは付けず内蔵の HSI)。精度 ±0.5%(出荷時)+ ±0.2%(温度、−40〜125°C)、共振抵抗 40Ω 以下(村田の仕様書 JGC42-8974A)。外付けのコンデンサは要らない。H725 の条件(臨界 gm 1.5mA/V 以下)に十分入る。PH0・PH1 のすぐそばに置く |

## 3. 電源

| 部品 | 品番・仕様 | 数 | 根拠・メモ |
|---|---|---|---|
| 電池のコネクタ | **BETAFPV BT2.0**(2ピン、バナナ型のピン。続けて9A、瞬間15A。オス0.34g + メス0.24g = 約0.58g。販売店の値)。**JST PHは使わない**(定格2A。MK3は1Sごとに PH でつないでいた) | 1組 | 2026-10-28決定(XT30は約1.7gで、約1.1g重い)。基板に直接付ける形は見つからないので、ケーブル付きのものを基板のパッドにはんだ付けする。接点の抵抗は公表されていないので、届いたら測る。付いてくる線が細ければ AWG22〜24 につけ替える。VBATの配線・パターンも8Aで太さを決める |
| 電池のバランス端子 | JST-XH 4ピン(3S) | 1 | 2026-10-29。バランス充電器で充電するため。電池の側に付け、基板にはつながない |
| 電源スイッチのMOSFET | **AOS AO4407A**: Pch、−30V、VGS ±25V、13mΩ以下 @ −10V、−12A、SO-8(脚あり、量産中)+ ゲートとソースの間に100kΩ(R1)と100nF(C1)、スライドスイッチとの間に10kΩ(R2) | 1 | 2026-10-12決定(電池から8A流れることがあるため、AO6403(−6A、35mΩ)から変更)。8Aで損失約0.83W(一瞬)、ふだんの1〜2Aで0.01〜0.05W。MK3のIRLML6402はVGSの最大が±12Vで、3Sでは超える |
| 電源スイッチ | SSSS810701(MOSFETのゲートをGNDに落としてONにする。スイッチには大きな電流が流れない) | 1 | MK3 |
| VBATのコンデンサ | 22µF(25V、セラミック)× 2 + ポリマー47µF(25V)× 1(案) | 3 | 仮。PWMのリップルと、電源を入れた瞬間の振動を抑える(ESRのあるポリマーで振動を止める)。回生でVBATが上がる分は小さい(`docs/spec.md`)。MP6551・DC-DCとも入力14V(絶対最大16V) |
| VBATのTVSダイオード | **SMF13A**(SOD-123FL、200W): 逆方向の動作電圧13V、降伏電圧14.4〜15.9V、9.3Aでのクランプ21.5V(販売店の値) | 1 | 12.6Vでは導通しない。ただし大きなサージではクランプ電圧が16Vを超えるので、これだけでは守れない。減速時に電池へ戻す電流(回生)をソフトで制限し、VBATのコンデンサと合わせて使う |
| 3.3VのDC-DC | 村田 LXDC55FAAA-203(入力4〜14V、出力1.5A、0.35g) | 1 | 決定 |
| 出力電圧の設定抵抗RFB | 1.30kΩ 1%(約3.31V) | 1 | DS: RFB = 7.29 /(Vout − 0.8)− 1.6 [kΩ](データシートの例は3.3Vで1.31kΩ) |
| DC-DCの出力コンデンサ | 22µF 10V(0805)× 2 | 2 | DS: 22〜150µF をモジュールの近くに。データシートの回路は GRM21BB30J226(22µF 6.3V)1個 |
| DC-DCの入力コンデンサ | 10µF 25V(0805)+ 100nF 25V | 各1 | データシートに値の指定はない(回路図にコンデンサがあるだけ)。VBATのコンデンサとは別に、モジュールのそばに置く。ENはVBATにつなぎ(常にON、ENの最大はVin)、PGは使わない |
| 電池の電圧の分圧 | 47kΩ + 10kΩ(12.6Vで約2.2V) | 各1 | MK3。MP6551のVINの近くから取る(2026-10-29決定)。止める電圧は合計11.3Vで、ソフトで判断する |

電源スイッチの回路(MK3と同じ): 電池の+ → MOSFETのソース、ドレイン → VBAT。ゲートとソースの間に10kΩ(ふだんはOFF)。スライドスイッチでゲートをGNDに落とすとONになり、VGS = −電池の電圧(3Sで最大−12.6V)。

- この回路は**電池の逆接続は防げない**(逆につなぐと、MOSFETの中のダイオードを通って回路に逆の電圧がかかる)。電池のコネクタは逆に挿さらない形のものにする
- ONにした瞬間、VBATのコンデンサへの突入電流が流れ、配線のインダクタンスとの振動でVBATが最悪で約2倍まで跳ねることがある。**ゲートとソースの間にコンデンサを足して、約1msかけてONにする**(2026-10-28。値は回路図を描くときに決める)。MOSFETのパルスの定格もデータシートで確かめる

## 4. モーター・ファン

| 部品 | 品番・仕様 | 数 | 根拠・メモ |
|---|---|---|---|
| モータードライバ | MPS MP6551GQB(QFN-14、2.5×3mm) | 2 | 決定 |
| ドライバのVINのコンデンサ | 100nF 25V(0603)+ 10µF 25V(0805) | 各2 | DS(100nF をICに一番近く、1〜10µF をそのそば)。2026-10-29 回路図 |
| CMの抵抗(VREFとRREF) | 3.3VとGNDの間に**4.7kΩ 1%を2本**(VREF 1.65V、RREF 2.35kΩ。+側 約0.29V/A で約5.4Aまで、−側 約0.22V/A) | 8(CM 4本 × 2) | 2026-10-29決定(6.2kΩ × 2 では+側が約4.3Aで振り切れるため)。ADCピンのそばに置く |
| CMのコンデンサ | 1nF(CMのピンとGNDの間、RREFのそば。RREFとで約2.4µs) | 4 | 2026-10-29決定。ADCが読むときの電荷もここから出る |
| SRの抵抗 | SRとGNDの間(0Ωで最速、3MΩで約3µs)。0Ωから始める | 2 | 仮。ノイズを見て上げる |
| nFAULTのプルアップ | 10kΩ(2個のnFAULTを共通に) | 1 | 仮 |
| ファンのスイッチ | Nch MOSFET IRLML6344 + ゲートのプルダウン10kΩ + ゲートに直列100Ω(仮、2026-10-29) | 各1 | MK3。ファンは1A程度(2026-10-12)なので足りる。MCUの3.3Vでゲートを動かすときのオン抵抗をデータシートで確かめる |
| ファンの還流ダイオード | ショットキーダイオード | 1 | MK3にもあり(品番は要選定) |
| ファンの電流のシャント | 0.1Ω(ケルビン接続)、1/4W以上 | 1 | 1Aで0.1V・0.1W |
| ファンの電流のRCフィルタ | 1kΩ + 1µF | 各1 | 仮 |
| 電流センスアンプ | 付けない(2026-10-29。モーターは MP6551 の CM、ファンは 0.1Ω のシャントを直接読む) | 0 | `docs/spec.md`の「MP6551の電流計測は使えるか」 |

## 5. センサ

| 部品 | 品番・仕様 | 数 | 根拠・メモ |
|---|---|---|---|
| IMU | LSM6DSR(LGA-14 2.5 × 3mm)+ VDD・VDDIO に 100nF ずつ | 1 + 2 | MK3。SPI(モード3)、SDX・SCX は GND、INT1・INT2 は今はつながない |
| エンコーダ | **MagnTek MT6835**(TSSOP-16、磁気式 AMR、21ビット、SPI モード3・最高 約16MHz、3.0〜5.5V・22mA)| 2 | 2026-10-29決定(AS5047P から変更。2026-10-17 に NJL5820R から AS5047P にしていた)。ノイズ 0.0015° rms(BW=5、AS5047P は 0.068°)、遅れ 約10µs(AS5047P は SPI で 90〜110µs)。磁石は IC の表面で 30mT 以上。精度は工場で ±0.5°、一定の速さで回して CAL_EN を上げる校正で ±0.07° |
| エンコーダの基板 | **5.3 × 12.3 × 0.6mm、2層、左右で同じ基板**(`hardware/kicad/KOGUMA-Mk4_Encoder`、マウント v9)。z 3.3〜15.6(x −2.65〜2.65、y ±20.4〜21.0)。メイン基板の穴を通して上の面で両面からはんだ付けする。MT6835 の中心は x 0、z 7.5(上の辺から8.1mm)。チップの面の部品はマウントのくぼみ(z 3.8〜11.3)の中だけ、C1 は裏の面 | 2 | 2026-10-29(v9 の 7.8 × 10.3mm から、左右で1種類にするため細くし、穴に通すため上に伸ばした)。面付けして注文 |
| エンコーダのパスコン | VDD に 0.1µF 0402(データシートの回路)。TEST・TEST_EN は GND。CAL_EN はメイン基板の PC15 へ(中に 250kΩ のプルダウン) | 2 | 2026-10-29。はんだジャンパの案はやめた(メイン基板の下に隠れて触れない) |
| エンコーダの基板とのつなぎ | 線は使わない。メイン基板に穴(NPTH 1.0 × 5.9mm)とパッド7つ(`KOGUMA-Mk4:ENC_Base_Slot`、J5・J6): 1 3.3V、2 CAL、3 MISO、4 MOSI、5 SCK、6 CS、7 GND | 2 | 2026-10-29 |
| 壁センサの発光 | OPV332 | 4 | MK3 |
| 壁センサの発光の定電流ドライバ | NJU6080(MK4は1個ずつ駆動するので4個) | 4 | MK3は2個 |
| NJU6080の電流設定 | 20Ω(10mA) | 4 | MK3 |
| NJU6080のパスコン | 100nF | 4 | MK3。NJU6080 は SOT-23-6、VDD 2.5〜5.5V(3.3V で使える)。ピンは 1 PWM、2 GND、3 Rs、4 LED、5 EN、6 VDD |
| 壁センサの受光 | SFH 229 FA | 4 | MK3 |
| 壁センサのホルダ | 光造形、JLC Black Resin(光を通さない黒)。v3: 6.0 × 4.04 × 10.3mm + 後ろの足、0.22g。下の端をフレームに両面テープで貼る。`mechanical/sensor_holder/sensor_holder_v2.stl` | 4 | 2026-10-30。ToraNeko.Mk3 のセンサホルダ v4 と同じ形で、**基板の裏に付ける**ため高さを 9.9mm にした。基板から遠い穴に発光、近い穴に受光(φ3.2)。穴が OPV332・SFH 229 FA にきつければ削る |
| 受光のアンプ | **TI OPA2354**(2回路入り、VSSOP-8、GBW 100MHz、入力容量 約2pF、入力電流 3pA、2.5〜5.5V)。U74 が FL・R、U75 が FR・L | 2 | 2026-10-29決定(AD8606 から変更)。受光を速くするため。足の並びは標準の2回路入り(AD8606 と同じ) |
| アンプの帰還 | 820kΩ + **0.5pF(C0G)** | 各4 | 2026-10-29(MK3 は 2.2pF)。帯域 約390kHz、1% まで 約1.9µs(MK3 は 約8µs)。0.5pF は浮遊容量が効くので、実機で波形を見て決める |
| PD_BIAS | 1kΩ + 47Ω の分圧(約0.15V)+ コンデンサ | 一式 | MK3 |
| アンプのパスコン | 100nF + 10µF(アンプのすぐそば) | 各2 | MK3 は 10µF だけ。速いアンプなので 100nF を足した |

## 6. 表示・入力・通信

| 部品 | 品番・仕様 | 数 | 根拠・メモ |
|---|---|---|---|
| LED | 0603 のチップLED(品番は要選定。MK3 の回路図も品番なし)。モード3 + ナンバー4 | 7 | 決定。GPIOがHで点灯(MK3と同じつなぎ方)。1kΩ で 約1mA なので、明るさの効率のよいものを選ぶ |
| LEDの抵抗 | 1kΩ | 7 | MK3 |
| 電源のLED | MK3と同じLED + 1kΩ(3.3VとGNDの間) | 1 | MK3 |
| ブザー | SMT-0540-S-R(定格3V) | 1 | MK3。MK4は3.3Vで鳴らす |
| ブザーのスイッチ | 2N7002 + ゲートのプルダウン 10kΩ + 還流ダイオード RB751S40(SOD-323、仮) | 各1 | MK3 |
| スイッチ | TVAF06-A020B-R + 3.3Vへのプルアップ10kΩ(押すとL)+ 100nF | 1 | MK3。100nF は 2026-10-29 に足した(チャタリングを少し減らす、約1ms) |
| デバッグの端子(J7) | 1.27mm 2 × 3 のピンヘッダ。**ToraNeko.Mk3 の J6 と同じ並び**: 1 3.3V、2 UART_TX、3 NRST、4 SWCLK、5 GND、6 SWDIO | 1 | 2026-10-29決定。STLINK-V3MODS で書き込み・デバッグとログ(仮想COMポート)。ToraNeko とケーブルを共用できる |
| UART_RX の端子(TP1) | テストパッド φ1.0mm | 1 | 2026-10-29。PC から送るときだけ線をつなぐ |

## まだ決めていないもの

- タイヤ・ホイール・車軸・軸受・電池のコネクタの品番
- LEDの品番(MK3の回路図に記載がない。MK3で使ったものを確かめる)
- モーターの取り付け(NFP-D8620用)
- 各部品の重さ(50gの配分に入るか)
