Tokoro0917/KOGUMA-Mk4/docs/calc/frame/frame_v6_8.dxf

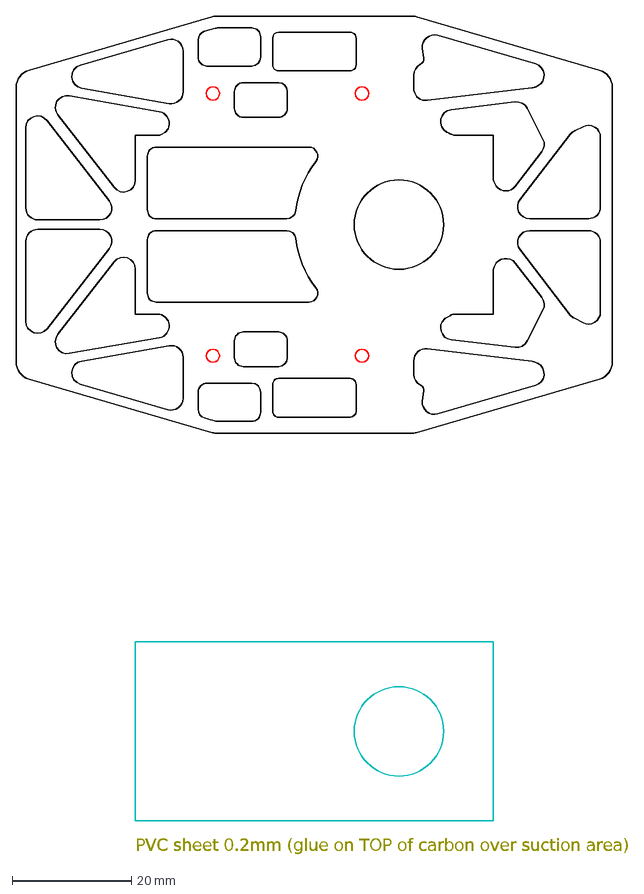
[picture p66: CAD file, 2026-10-31]
docs/calc/frame/frame_v6_8.dxf
PVC sheet 0.2mm (glue on TOP of carbon over suction area)
