Tokoro0917/KOGUMA-Mk4/mechanical/battery_holder/battery_holder_R_v1.step

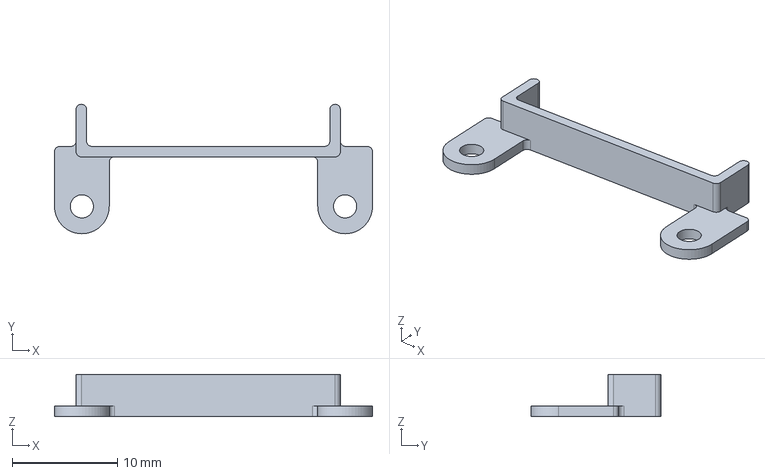
[picture p67: CAD file, 2026-11-01]
mechanical/battery_holder/battery_holder_R_v1.step
30.2 x 12.3 x 4.00 mm
