Tokoro0917/KOGUMA-Mk4/mechanical/fan_mount/fan_mount_v1.step

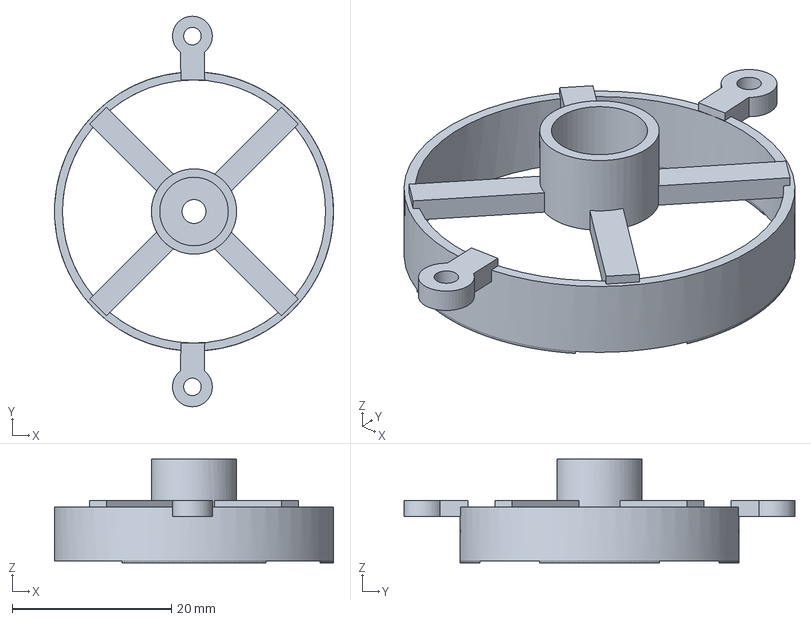
[picture p68: CAD file, 2026-10-29]
mechanical/fan_mount/fan_mount_v1.step
35.0 x 49.0 x 13.0 mm
