Tokoro0917/KOGUMA-Mk4/mechanical/frame/frame_v6_9.dxf

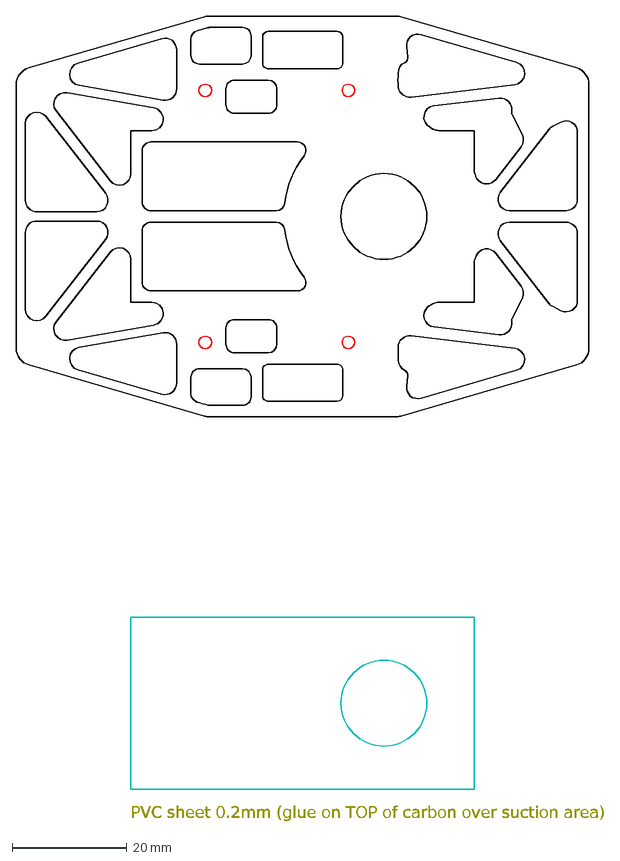
[picture p69: CAD file, 2026-11-01]
mechanical/frame/frame_v6_9.dxf
PVC sheet 0.2mm (glue on TOP of carbon over suction area)
