Tokoro0917/KOGUMA-Mk4/mechanical/motor_mount/motor_mount_R_v11.step

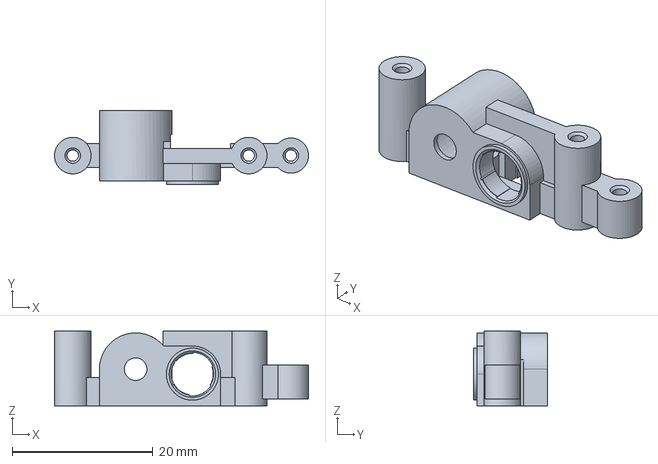
[picture p70: CAD file, 2026-11-01]
mechanical/motor_mount/motor_mount_R_v11.step
36.1 x 10.5 x 10.6 mm
