Tokoro0917/KOGUMA-Mk4/mechanical/sensor_holder/sensor_holder_v4.step

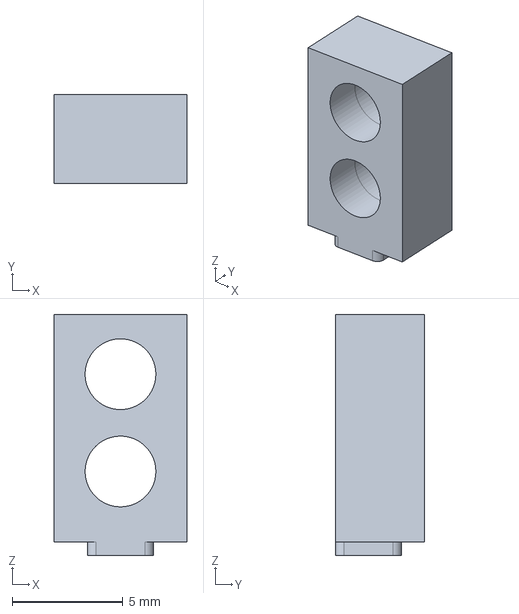
[picture p71: CAD file, 2026-11-01]
mechanical/sensor_holder/sensor_holder_v4.step
6.00 x 4.04 x 10.9 mm
