Tokoro0917/KOGUMA-Mk4/mechanical/vehicle/mk4_vehicle_v4.step

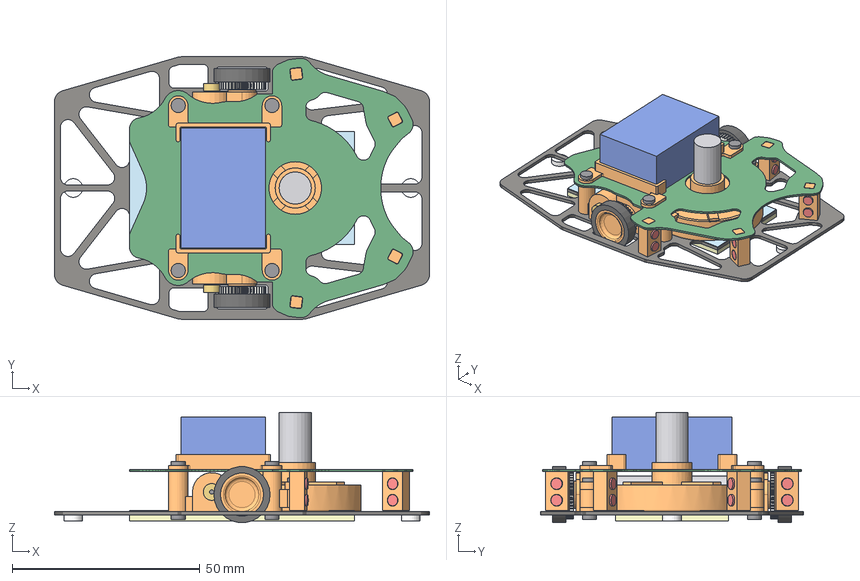
[picture p72: CAD file, 2026-11-01]
mechanical/vehicle/mk4_vehicle_v4.step
100.0 x 70.0 x 29.3 mm
frame
pc_sheet
skirt
skid_F
skid_R
mount_R
mount_L
wheel_R
wheel_L
spur41_R
spur41_L
pin_R
pin_L
brg_out_R
brg_out_L
brg_in_R
brg_in_L
magnet_R
magnet_L
as5047p_R
as5047p_L
enc_board_R
enc_board_L
tire_R
tire_L
motor_R
motor_L
shaft_R
shaft_L
pinion_R
pinion_L
fan_case
impeller
fan_motor
fan_shaft
pcb
battery
battery_holder_L
battery_holder_R
sensor_holder_FL
sensor_FL_emit
sensor_FL_recv
sensor_holder_FR
sensor_FR_emit
sensor_FR_recv
sensor_holder_R
sensor_R_emit
sensor_R_recv
sensor_holder_L
sensor_L_emit
sensor_L_recv
screw_mountF_L
screw_mountR_L
screw_post_L
screw_fan_L
screw_mountF_R
screw_mountR_R
screw_post_R
screw_fan_R
screw_fanjoint_0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
