Tokoro0917/KOGUMA-Mk4/mechanical/wheel/wheel_R_v1.step

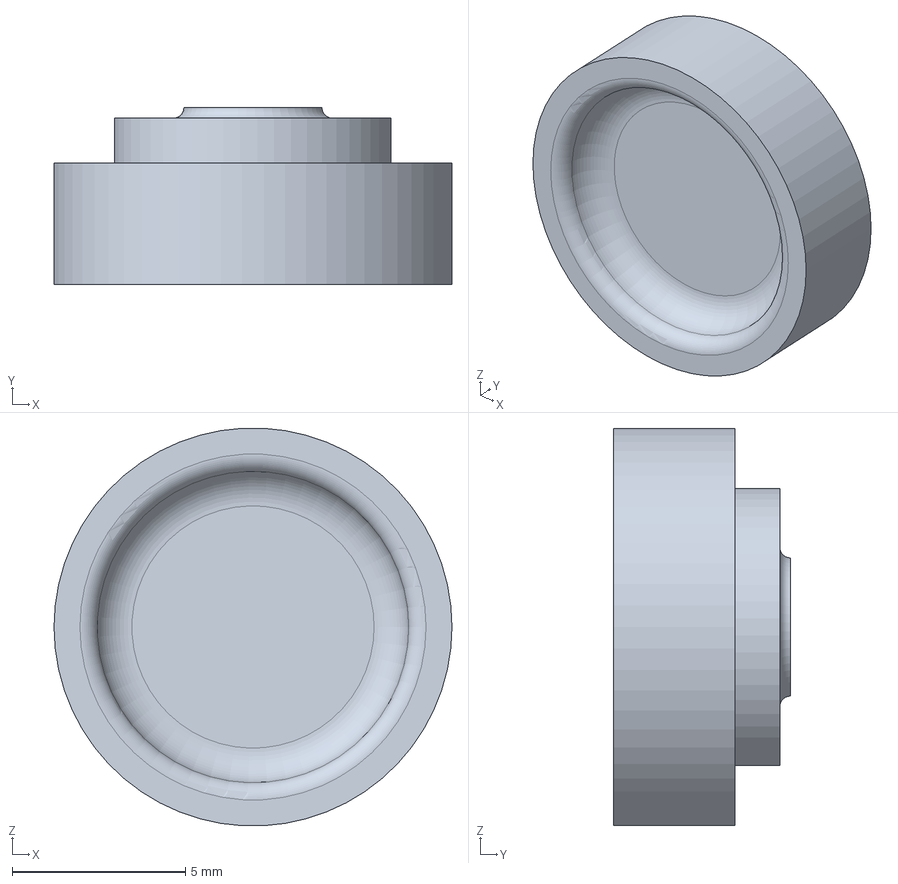
[picture p73: CAD file, 2026-10-30]
mechanical/wheel/wheel_R_v1.step
11.5 x 5.10 x 11.5 mm
