Tokoro0917/KOGUMA-Mk4/mechanical/frame/MK4PC69_T02.dxf

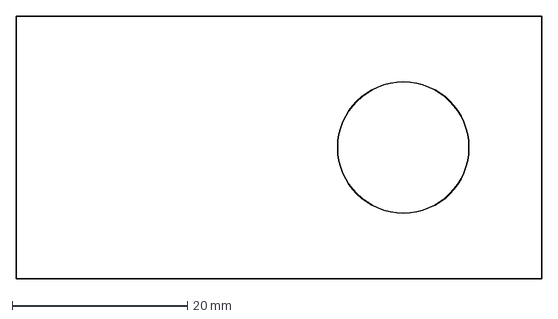
[picture p74: CAD file, 2026-11-01]
mechanical/frame/MK4PC69_T02.dxf
60.0 x 30.0 mm
