Tokoro0917/KOGUMA-Mk4/mechanical/pcb/pcb_outline_v17.dxf

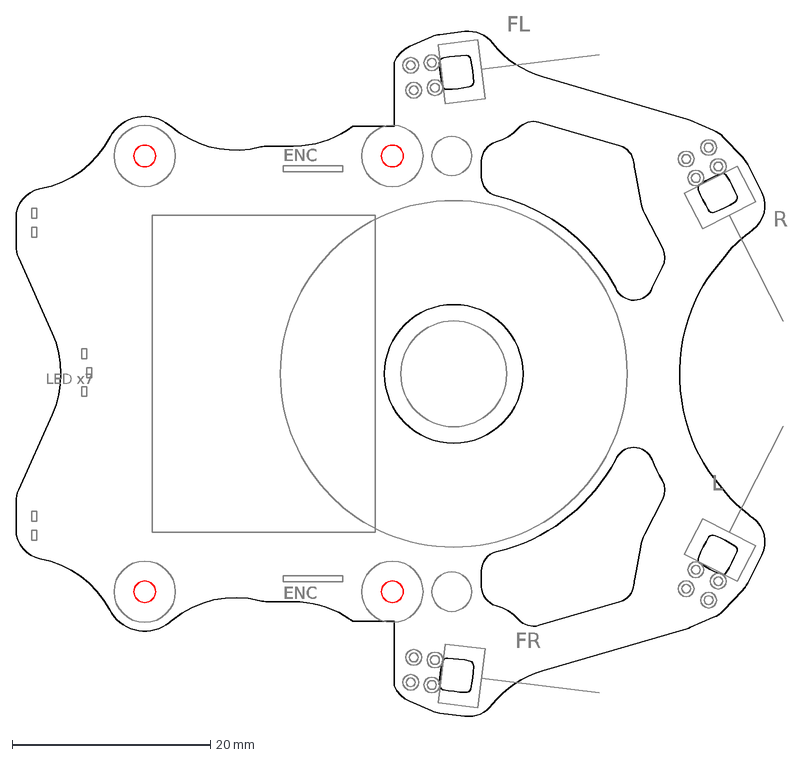
[picture p75: CAD file, 2026-11-01]
mechanical/pcb/pcb_outline_v17.dxf
ENC
LED x7
FL
FR
R
L
