Tokoro0917/KOGUMA-Mk4/mechanical/frame/MK4FRAME69_T1.dxf

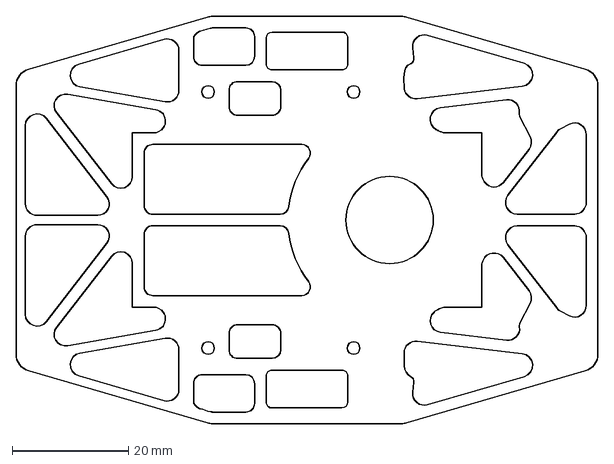
[picture p76: CAD file, 2026-11-01]
mechanical/frame/MK4FRAME69_T1.dxf
100.0 x 70.0 mm
