Tokoro0917/KOGUMA-Mk4/mechanical/motor_mount/mk4_drive_R_check.step

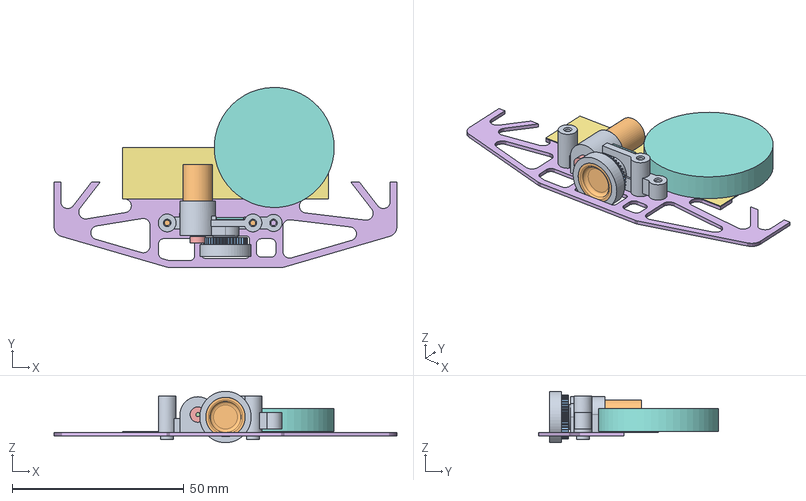
[picture p77: CAD file, 2026-10-29]
mechanical/motor_mount/mk4_drive_R_check.step
100.0 x 52.5 x 15.0 mm
