Tokoro0917/KOGUMA-Mk4/mechanical/frame/frame_v6_9_3d.step

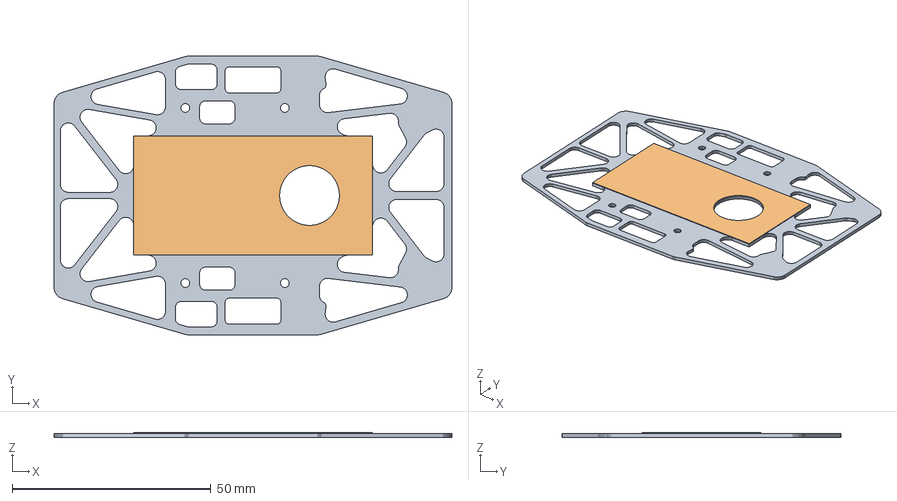
[picture p78: CAD file, 2026-11-01]
mechanical/frame/frame_v6_9_3d.step
100.0 x 70.0 x 1.20 mm
