Tokoro0917/KOGUMA-Mk4/mechanical/frame/MK4FRAME68_T1.dxf

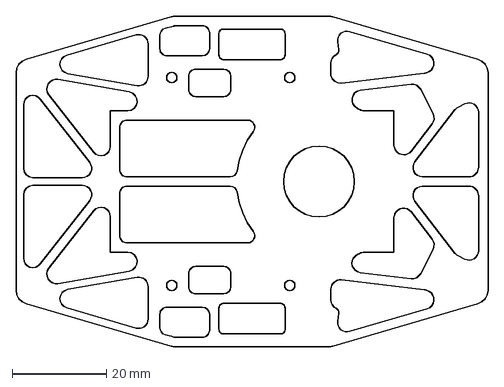
[picture p79: CAD file, 2026-10-31]
mechanical/frame/MK4FRAME68_T1.dxf
100.0 x 70.0 mm
