Tokoro0917/KOGUMA-Mk4/mechanical/frame/MK4PC68_T02.dxf

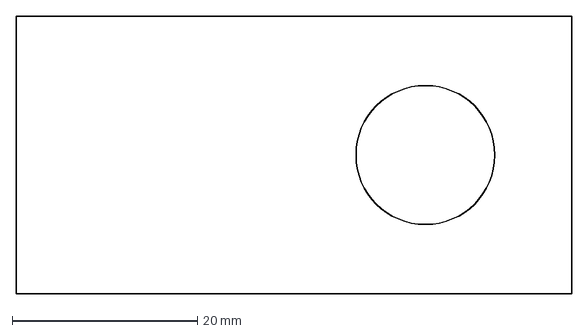
[picture p80: CAD file, 2026-10-31]
mechanical/frame/MK4PC68_T02.dxf
60.0 x 30.0 mm
