Tokoro0917/KOGUMA-Mk4/mechanical/motor_mount/tn_drive_mk4_right.step

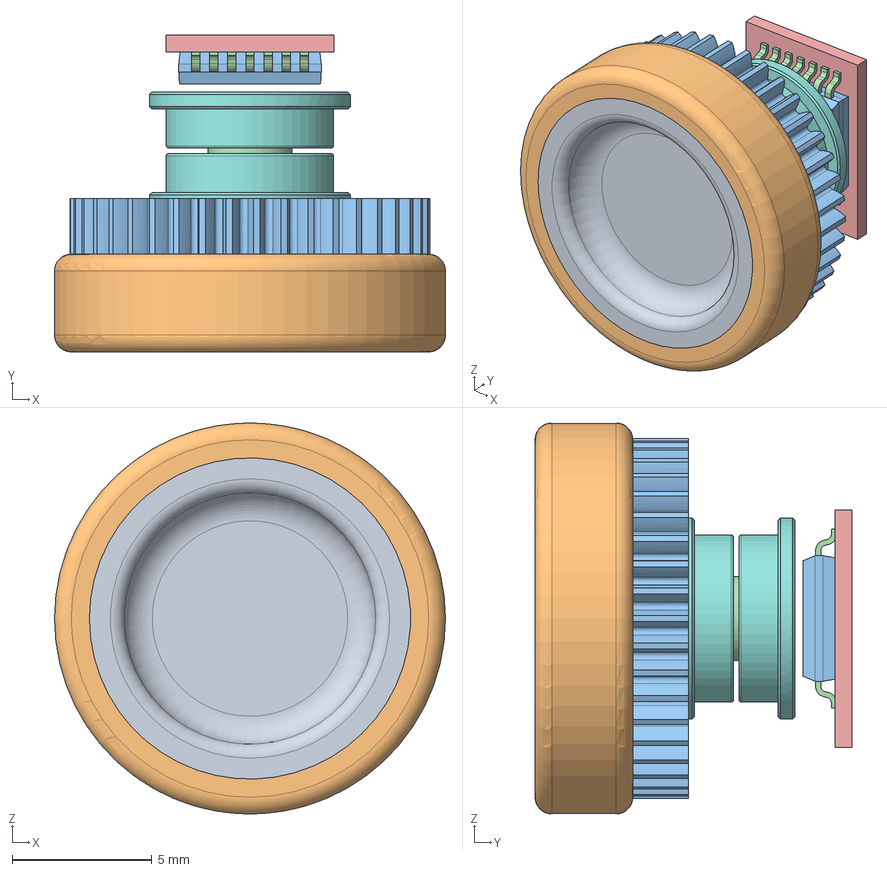
[picture p84: CAD file, 2026-10-19]
mechanical/motor_mount/tn_drive_mk4_right.step
14.0 x 11.3 x 14.0 mm
