Tokoro0917/KOGUMA-Mk4/mechanical/frame/MK4PC65_T02.dxf

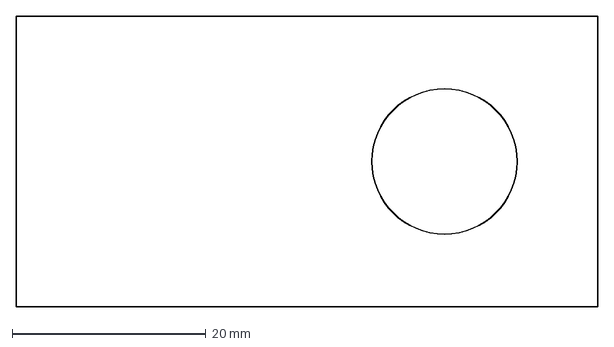
[picture p85: CAD file, 2026-10-20]
mechanical/frame/MK4PC65_T02.dxf
60.0 x 30.0 mm
