Tokoro0917/KOGUMA-Mk4/mechanical/frame/MK4FRAME64_T1.dxf

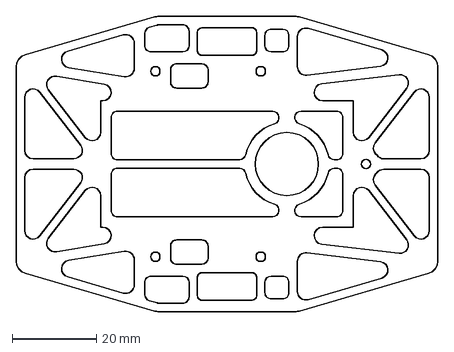
[picture p87: CAD file, 2026-10-20]
mechanical/frame/MK4FRAME64_T1.dxf
100.0 x 70.0 mm
