Tokoro0917/KOGUMA-Mk4/mechanical/frame/MK4PC62_T02.dxf

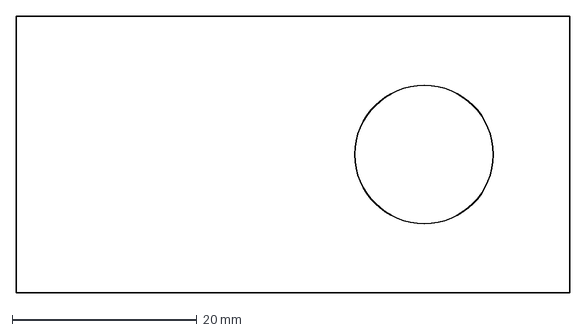
[picture p88: CAD file, 2026-10-19]
mechanical/frame/MK4PC62_T02.dxf
60.0 x 30.0 mm
