Tokoro0917/KOGUMA-Mk4/mechanical/frame/MK4FRAME62_T1.dxf

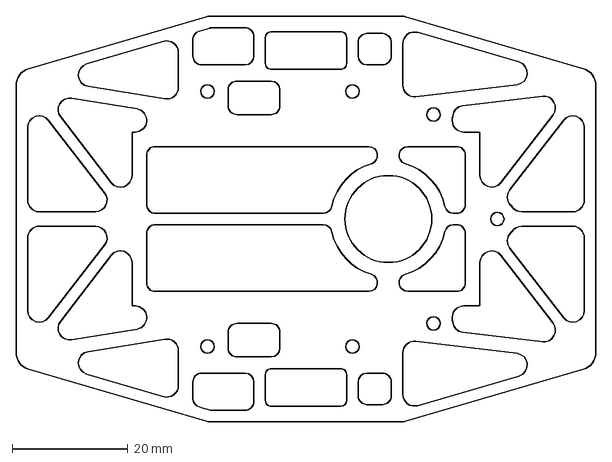
[picture p89: CAD file, 2026-10-19]
mechanical/frame/MK4FRAME62_T1.dxf
100.0 x 70.0 mm
