Tokoro0917/KOGUMA-Mk4/mechanical/frame/MK4PC61_T02.dxf

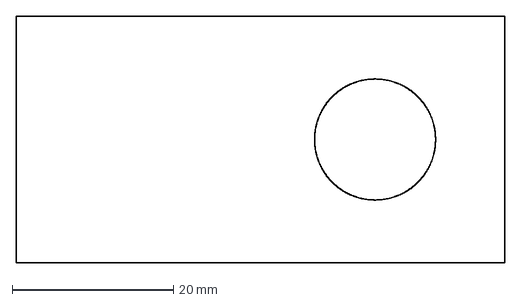
[picture p90: CAD file, 2026-10-19]
mechanical/frame/MK4PC61_T02.dxf
60.5 x 30.5 mm
