Tokoro0917/KOGUMA-Mk4/mechanical/frame/MK4FRAME61_T1.dxf

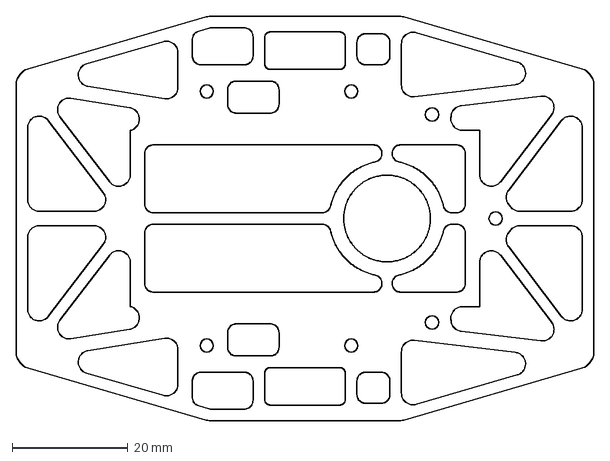
[picture p91: CAD file, 2026-10-19]
mechanical/frame/MK4FRAME61_T1.dxf
100.0 x 70.0 mm
