Tokoro0917/KOGUMA-Mk4/mechanical/frame/MK4FRAME60_T1.dxf

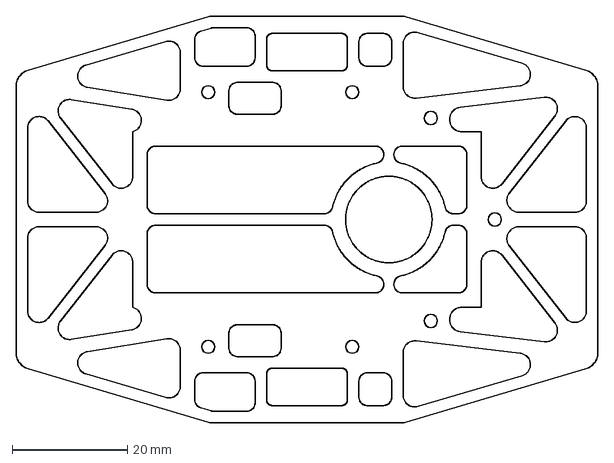
[picture p93: CAD file, 2026-10-19]
mechanical/frame/MK4FRAME60_T1.dxf
101.0 x 70.6 mm
