Tokoro0917/KOGUMA-Mk4/(list of files, cad)

Other CAD files:
mechanical/battery_holder/battery_holder_L_v1.step
mechanical/motor_mount/motor_mount_L_v11.step
mechanical/wheel/wheel_L_v1.step
docs/calc/frame/frame_v4.dxf
docs/calc/frame/frame_v4_1.dxf
docs/calc/frame/frame_v4_2.dxf
docs/calc/frame/frame_v4_3.dxf
docs/calc/frame/frame_v4_4.dxf
docs/calc/frame/frame_v4_5.dxf
docs/calc/frame/frame_v4_6.dxf
docs/calc/frame/frame_v4_7.dxf
docs/calc/frame/frame_v5.dxf
docs/calc/frame/frame_v6.dxf
docs/calc/frame/frame_v6_1.dxf
docs/calc/frame/frame_v6_2.dxf
docs/calc/frame/frame_v6_3.dxf
docs/calc/frame/frame_v6_4.dxf
docs/calc/frame/frame_v6_5.dxf
docs/calc/frame/frame_v6_6.dxf
docs/calc/frame/frame_v6_7.dxf
mechanical/battery_holder/battery_holder_L_v1.stl
mechanical/battery_holder/battery_holder_R_v1.stl
mechanical/fan_mount/fan_mount_v1.stl
mechanical/frame/frame_v6.dxf
mechanical/motor_mount/motor_mount_L_v11.stl
mechanical/motor_mount/motor_mount_L_v2.step
mechanical/motor_mount/motor_mount_L_v5.step
mechanical/motor_mount/motor_mount_L_v6.step
mechanical/motor_mount/motor_mount_R_v11.stl
mechanical/motor_mount/motor_mount_R_v2.step
mechanical/motor_mount/motor_mount_R_v5.step
mechanical/motor_mount/motor_mount_R_v6.step
mechanical/pcb/pcb_outline_v10.dxf
mechanical/pcb/pcb_outline_v11.dxf
mechanical/pcb/pcb_outline_v12.dxf
mechanical/pcb/pcb_outline_v13.dxf
mechanical/pcb/pcb_outline_v14.dxf
mechanical/pcb/pcb_outline_v15.dxf
mechanical/pcb/pcb_outline_v16.dxf
mechanical/pcb/pcb_outline_v6.dxf
mechanical/pcb/pcb_outline_v7.dxf
mechanical/pcb/pcb_outline_v8.dxf
mechanical/pcb/pcb_outline_v9.dxf
mechanical/sensor_holder/sensor_holder_v4.stl
mechanical/wheel/wheel_L_v1.stl
mechanical/wheel/wheel_R_v1.stl
