Tokoro0917/KOGUMA-Mk4/mechanical/frame/MK4PC69_template_A4_1to1.pdf

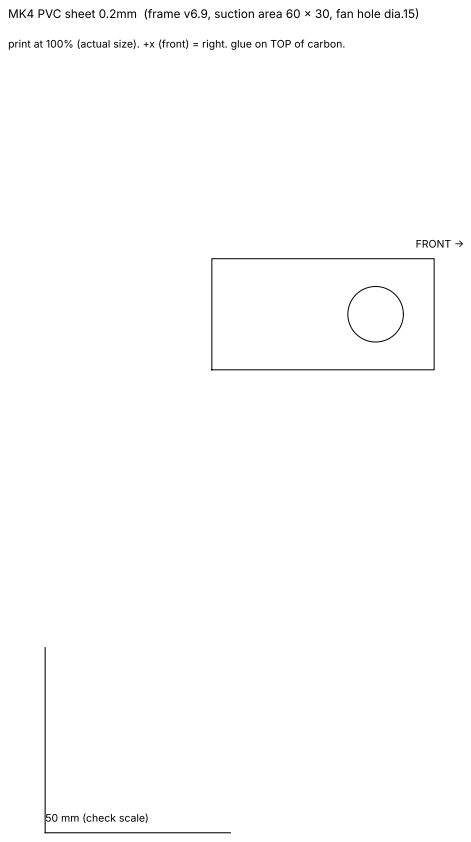
[picture p94: page 1]
FRONT ->

MK4 PVC sheet 0.2mm (frame v6.9, suction area 60 x 30, fan hole dia.15)

print at 100% (actual size). +x (front) = right. glue on TOP of carbon.

50 mm (check scale)
