Tokoro0917/KOGUMA-Mk4/hardware/kicad/KOGUMA-Mk4_Encoder/KOGUMA-Mk4_Encoder.kicad_pcb

## KiCad design hardware/kicad/KOGUMA-Mk4_Encoder/KOGUMA-Mk4_Encoder.kicad_pcb (2026-10-30)

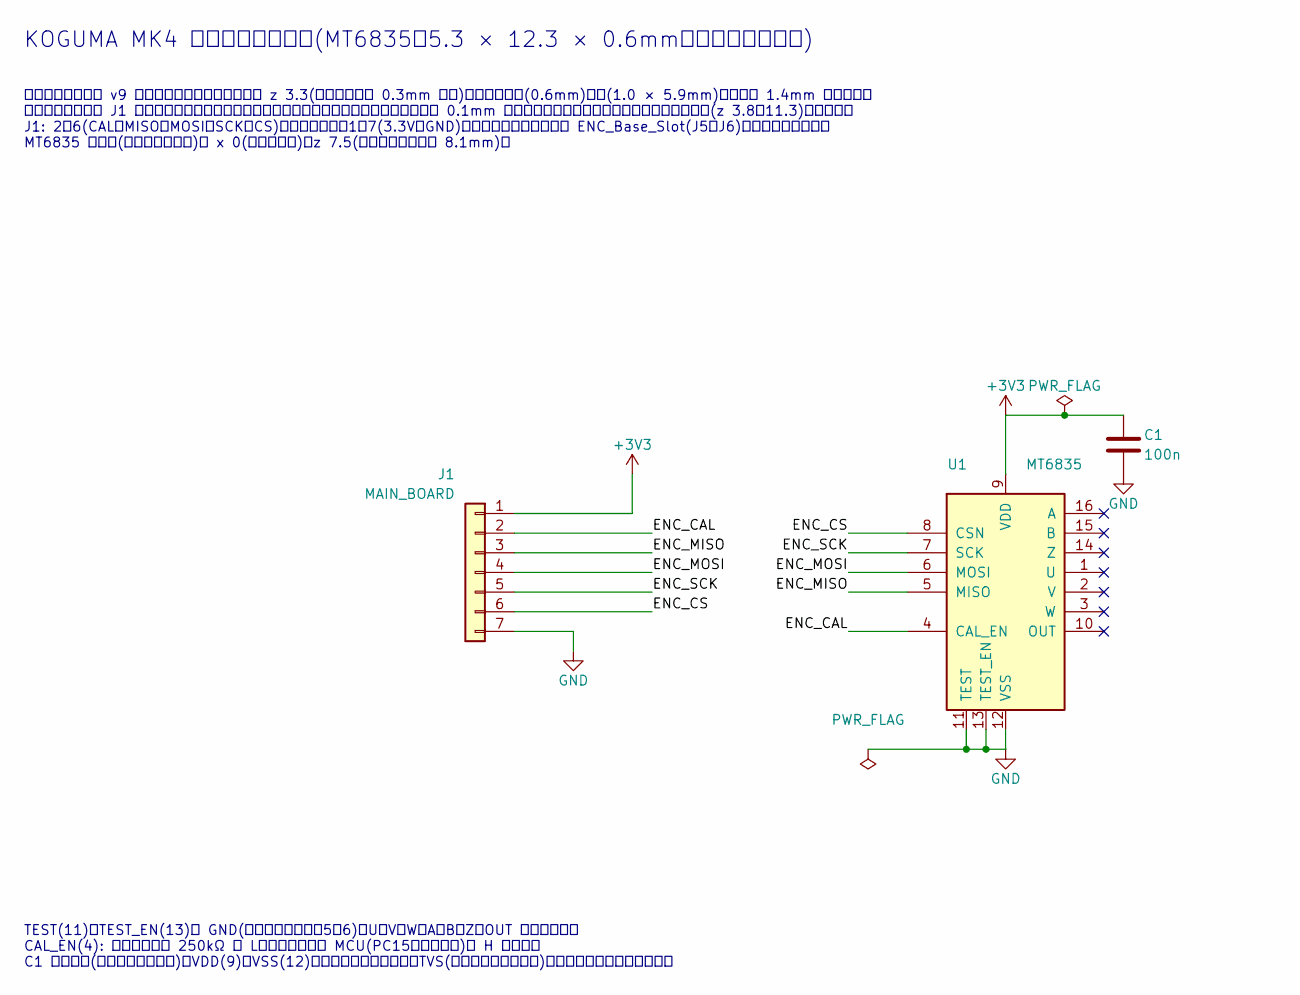
[picture p95: schematic KOGUMA-Mk4_Encoder.kicad_sch, KOGUMA MK4 encoder (MT6835)]

Parts:
C1: 100n; C_0402_1005Metric
J1: MAIN_BOARD; ENC_Edge
U1: MT6835; TSSOP-16_4.4x5mm_P0.65mm_Pad0.35

Connections:
+3V3: C1.1, J1.1, U1.9 (VDD)
/ENC_CAL: J1.2, U1.4 (CAL_EN)
/ENC_CS: J1.6, U1.8 (CSN)
/ENC_MISO: J1.3, U1.5 (MISO)
/ENC_MOSI: J1.4, U1.6 (MOSI)
/ENC_SCK: J1.5, U1.7 (SCK)
GND: C1.2, J1.7, U1.11 (TEST), U1.12 (VSS), U1.13 (TEST_EN)

Notes on the sheet:
KOGUMA MK4 エンコーダの基板(MT6835、5.3 × 12.3 × 0.6mm、左右で同じ基板)
モーターマウント v9 に合わせる。基板の下の辺は z 3.3(フレームから 0.3mm 浮く)。メイン基板(0.6mm)の穴(1.0 × 5.9mm)を通って 1.4mm 上に出し、 メイン基板の上で J1 のパッドを両面からはんだ付けする。チップの面はマウントの面から 0.1mm なので、チップの面の部品はマウントのくぼみ(z 3.8〜11.3)の中だけ。 J1: 2〜6(CAL、MISO、MOSI、SCK、CS)はチップの面、1・7(3.3V、GND)は裏の面。メイン基板の ENC_Base_Slot(J5・J6)と番号を合わせる。 MT6835 の中心(磁気を測る中心)は x 0(車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
TEST(11)・TEST_EN(13)は GND(データシートの図5・6)。U・V・W・A・B・Z・OUT は使わない。 CAL_EN(4): ふだんは中の 250kΩ で L。校正のときに MCU(PC15、左右共通)が H にする。 C1 は裏の面(内側は開いている)、VDD(9)・VSS(12)のビアのすぐ上に置く。TVS(データシートの推奨)は場所がないので付けない。

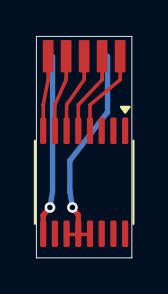
[picture p96: board KOGUMA-Mk4_Encoder.kicad_pcb from above]

Board: 2 copper layers, 5.3 x 12.3 mm, 3 parts (1 on the bottom side), 7 nets.
