Tokoro0917/KOGUMA-Mk4/(commit log)

2026-10-09 MK4のハード仕様の初版と駆動系の計算を追加
    モーター(NFP-D8620 7.4V版を片側1個)、2S、MK3と同じスパー、吸引600g目標を決定。
    直線の加速・グリップ・V90のdutyの見積もりを docs/calc/drive_calc.py で出せるようにした。
    Claude-Session: https://claude.ai/code/session_0156Q4g8mrzo4MjueC94bbUc
2026-10-09 スパー70T・エンコーダ41Tを反映し、ピニオンごとのギア比の表を追加
    MK3のGEARRATIO(70/41)はエンコーダの比だったので、MK3と比べている計算に注意書きを付けた。
    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
2026-10-09 MK3のモーター(NFP-D0816-3)を反映し、MK3のピニオン20T/41T相当の両方で比較
    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
2026-10-09 MK3のピニオン20Tを確定し、約1.3Aの頭打ちとドライバの要件を追記
    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
2026-10-09 電池(MK3は4S 180mAh)と電圧降下の切り分けを追記
    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
2026-10-09 MK3の回路(MP6550のISET 2kΩ=約2.5A)を反映し、ドライバの要件を追記
    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
2026-10-10 MP6550の電流制限の動きをデータシートで確認し、VISENの0.1µFを有力な原因として追記
    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
2026-10-10 モータードライバの候補(DRV8874/DRV8214ほか)の比較を追加
    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
2026-10-10 方針変更: タイヤ径15mm・軽量化に合わせて計算とギアの案を作り直す
    計算スクリプトに --tire / --mass を追加し、V90の慣性モーメントは
    MK3の約1.3Aの頭打ちから逆算する形にした。
    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
2026-10-10 質量40g目標・モジュール0.3に合わせて計算とギア・ドライバ・吸引の案を更新
    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
2026-10-10 モーターの外形(軸径1.2mm)とアールティで手に入るギアを追記
    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
2026-10-10 スパーをアールティの38Tに決定し、軸径1.2mm用ピニオンの探し方を追記
    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
2026-10-11 ピニオンは自分で入手するので、探し方の表を外す
    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
2026-10-11 エンコーダを光学式(NJL5820R+PCBのエンコーダ板)にし、板を付ける場所の比較を追記
    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
2026-10-11 エンコーダ板にsatoshihamasuna/encoder_diskの100prを使う案を追記
    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
2026-10-11 エンコーダ板はencoder_diskの100prをそのまま使うことに決定
    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
2026-10-11 電池を3Sに変更し、ドライバをDRV8874に戻す。3Sでの電圧・電流の注意を追記
    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
2026-10-11 3Sでの電流の目安(電流制限の設定と電池の放電電流)を追記
    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
2026-10-11 電池を3S 180mAh 30Cに決定
    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
2026-10-11 質量の目標を50gに変更し、計算・電流の目安・質量の配分を更新
    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
2026-10-11 吸引ファン(モーターは走行用と同じ予定、羽根は自作)の見積もりを追記
    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
2026-10-12 MCUの候補(STM32H7A3RIほか)の比較を追記
    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
2026-10-12 MCUをSTM32H725RGに決定し、確かめることを追記
    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
2026-10-12 STM32H725の採用実績の調査結果とIO数を追記
    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
2026-10-12 外付けメモリは付けず、内蔵Flashの使い方の案を追記
    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
2026-10-12 通信はMK3と同じUART+SWDに決定
    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
2026-10-12 壁センサはMK3と同じ回路に決定し、ピンの見積もりを追記
    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
2026-10-12 LEDをモード・ナンバー表示用に8個にし、ピンの見積もりを38本に更新
    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
2026-10-12 LEDを7個(モード3ビット+ナンバー4ビット)に決定
    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
2026-10-12 STM32H725RGのピンの割り当て表と、STのピン定義で確かめるスクリプトを追加
    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
2026-10-12 STM32H725RG(VFQFPN68)の電源(SMPS専用)の仕様を追記
    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
2026-10-12 5Vをなくし、電源を3.3Vの1系統にする。壁センサの発光は1個ずつ駆動
    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
2026-10-12 3.3VのDC-DCをLXDC55FAAA-203に決定
    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
2026-10-12 モータードライバをMP6551に変更し、電流の測り方とピンの割り当てを更新
    IN1・IN2の両方をPWMにして下側のFETで減衰させ、CM1・CM2を別々に読む。
    UARTはUSART1のPB14・PB15へ移した。
    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
2026-10-12 仕様書のモータードライバの項をMP6551に書き換え、Pythonのキャッシュを除外
    前のコミットでは仕様書の書き換えが抜けていたので、ここで入れる。
    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
2026-10-12 IMUはLSM6DSRのまま。ファンの電流の計測(シャント0.1Ω、PB0)を追加
    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
2026-10-12 電流の計測のノイズ対策を追記
    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
2026-10-12 部品表(案)を追加
    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
2026-10-12 制御周期(10kHz、マルチレート)の検討を追記
    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
2026-10-12 速度はエンコーダとIMUの加速度を組み合わせて推定することに決定
    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
2026-10-12 電流制御(トルク制御)の構成を追記
    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
2026-10-12 制御の設計(案)を追加
    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
2026-10-12 トレッド55mmと、位置・向きの制御の段階的な方針を決定
    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
2026-10-12 制御の周期(電流20kHz・速度1kHzから)と相補フィルタを決定
    carmineのソフトウェア解説を参考にした。
    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
2026-10-12 機構の配置(案v1)と上から見た図を追加
    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
2026-10-12 機構の配置(案v1)を取り消す
    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
2026-10-12 SMPSのインダクタ(DFE201610E-2R2M)とTVS(SMF13A)を選定し、回生電流の制限を追記
    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
2026-10-12 水晶はなし、LEDとスイッチはMK3と同じに決定
    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
2026-10-12 電源スイッチのMOSFETをDMP3028LFDEに選定
    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
2026-10-12 電源スイッチのMOSFETをSOT-23のAO3407(第一候補)に変更
    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
2026-10-12 電源スイッチのMOSFETをAO6403(TSOP-6)に決定
    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
2026-10-12 電池を3S 180mAh 45C(8A程度)に変更し、電源スイッチのMOSFETをAO4407Aに
    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
2026-10-12 ファンの電流を1A程度とし、起動時の電流の注意を追記
    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
2026-10-17 タイヤ径を15mmから14mmに変更し、関係する計算を直す
    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
2026-10-17 スパーを手持ちの41Tに変更し、ピニオンの第一案を13Tにする
    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
2026-10-17 足回りをToraNeko.Mk3と同じにし、エンコーダを磁気式(AS5047P)に変更
    ピニオン11T(ギア比3.73)、軸受LF-630、3x6平行ピン、ミニッツタイヤ14mm。
    エンコーダはSPI2で読み、UARTはPB6・PB7に移した(ピンの確認OK、41本使用)。
    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
2026-10-17 ピニオンを13T(41T:13T、軸間8.10mm)にし、タイヤを15mmに戻す
    NFP-D8620はNFP-D0812より太く、11Tでは軸受と当たるため。
    タイヤ15mmでスパー41Tから床まで約1.05mm。
    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
2026-10-17 機構の配置(案)を追加し、慣性モーメントを約220 g·cm²に見直す
    重心・吸引の中心は車軸の上。ターンの入りの電流(V90 3300で約4.6A)と
    フレームの重さ(約5.4g)を課題として記録。
    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
2026-10-17 ねじを鉄の低頭小ねじ M3×L10 に決め、部品表に追加
    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
2026-10-17 ねじにL5を追加(基本はL5)
    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
2026-10-17 ねじはナットで留める(相手はプラスチック)
    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
2026-10-17 MK3のFusionデータの場所と、部品ごとのMK4での扱いを追記
    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
2026-10-17 MK3のSTEPから実寸・重さ・慣性モーメントを読み、仕様書に追記
    MK3の慣性モーメントは約450 g·cm²(電流からの逆算約210は頭打ちで過小)。
    トレッド約60.6mm、スパー71T、タイヤ24mm。GEARRATIOの1.4%のずれも記録。
    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
2026-10-17 車高をフレームの下面2.0mmに決め、モーター・エンコーダの高さを記録
    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
2026-10-17 フレームの強度をFEMで計算し、frame_v4(骨G + 縦リブ)を追加
    1mmカーボン + 0.2mmポリカーボネートのフレームを、曲げ・面内・振動・座屈で計算。
    今の形と比べ、前の滑り板のたわみ -70%、角のたわみ -91%、1次の振動数 2.3倍、
    正面衝突の座屈 3.7倍(重さ +1.7g)。計算のスクリプト、結果、製作用DXFも追加。
    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
    [frame_v4.dxf]
2026-10-17 モーターマウント v1 を追加し、フレームを v4.1 に合わせる
    ToraNeko.Mk3 の足回りをそのまま使い、NFP-D8620・41T:13T に合わせたマウント
    (1個0.83g、M3×2本)を CadQuery で作成。ToraNeko の STEP から足回りの部品を
    MK4 の位置に置き、ぶつかりとすき間を確認。フレームはタイヤの穴・M3の穴・
    骨Gの始まりを合わせて強度を計算し直した(v4.1)。
    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
    [frame_v4_1.dxf, mk4_drive_R_check.step, motor_mount_L_v1.step, motor_mount_L_v1.stl, motor_mount_R_v1.step, motor_mount_R_v1.stl, tn_drive_mk4_right.step]
2026-10-17 フレーム v4.1 の3Dモデル(板・リブ・ポリカーボネート)と絵を追加
    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
    [frame_v4_1_3d.step]
2026-10-18 カーボン板の注文用ファイルを追加し、溝の幅を業者の決まりに合わせる
    リブの溝を1.6mm(最小の溝幅1.5mm)にし、溝の両側に1.5mmの肉を残すため骨Gを4.6mmに。
    注文用のDXF(フレーム + リブ)、ポリカーボネートのDXFと1:1の型紙、
    注文のしかた(カーボンラボ.jp の入稿の決まり)を docs/frame.md に追記。
    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
    [MK4FRAME41_T1.dxf, MK4PC41_T02.dxf, frame_v4_1.dxf, frame_v4_1_3d.step]
2026-10-18 DXF の閉じた線で、始点と終点が重ならないようにする
    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
    [MK4FRAME41_T1.dxf, MK4PC41_T02.dxf, frame_v4_1.dxf]
2026-10-18 リブあり・なしの比較を追記
    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
2026-10-18 フレームをリブなしの v4.2 にする(骨G 3.5mm)
    リブなしで骨・枠の組み合わせを32通り計算し直し、骨Gの幅を3.5mmにした。
    注文用の DXF・型紙、3D の STEP、マウントの確認を作り直し、文書を更新した。
    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
    [MK4FRAME42_T1.dxf, MK4PC42_T02.dxf, frame_v4_1_3d.step, frame_v4_2.dxf, frame_v4_2_3d.step, mk4_drive_R_check.step]
2026-10-18 ポケット加工で軽くできるかを計算する
    働いていない所を0.5mmに掘った場合、同じ所を窓にした場合、板全体を0.8mmにした場合を比べた。
    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
2026-10-18 フレームを v4.3 にする(マウントの下に窓)
    ポケット加工より窓の方が軽くなるので、働いていない所のうち、マウントの下
    (後ろのねじとエンコーダ基板の間)に窓を開けた。横の帯は衝突の守りのため残した。
    カーボン 5.48g → 5.30g、硬さはほぼ同じ。注文用の DXF・型紙・3D・確認を作り直した。
    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
    [MK4FRAME43_T1.dxf, MK4PC43_T02.dxf, frame_v4_2_3d.step, frame_v4_3.dxf, frame_v4_3_3d.step, mk4_drive_R_check.step]
2026-10-18 ねじ穴を足すときの決まりと、M3の穴を置ける所の図を追加
    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
2026-10-18 前後の窓に筋交いA(2.0mm)を足し、フレームを v4.4 にする
    角から背骨の根元への細い筋交いを4本足した。幅1.5〜2.5mmで差が小さいので、
    加工の公差を見て2.0mmにした。注文用の DXF・型紙・3D・確認を作り直した。
    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
    [MK4FRAME44_T1.dxf, MK4PC44_T02.dxf, frame_v4_3_3d.step, frame_v4_4.dxf, frame_v4_4_3d.step, mk4_drive_R_check.step]
2026-10-18 機体の仮の案 v0 を追加
    フレーム v4.4、マウント(後ろの耳に基板を受ける柱)、足回り、吸引ファン、基板、電池、
    壁センサ、滑り板、スカート、ねじを並べた。ぶつかり・重さ(59.5g)・重心・慣性モーメント
    (293 g·cm²)を計算し、STEP と図を出した。
    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
    [mk4_vehicle_v0.step]
2026-10-18 機体の仮の案を v1 に軽くする(59.5g → 54.3g)
    フレームの下の4本だけ鉄の低頭ねじにし、ナットと基板のねじはナイロンにした。
    基板を0.6mmに、ファンのケースを薄くして押さえをなくした。マウントの後ろの柱に
    横から入れるナットを作れるようにした。50gにするための電池・ファンのモーターの案も計算した。
    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
    [mk4_vehicle_v0.step, mk4_vehicle_v1.step]
2026-10-18 機体の計算に細いねじ(M2・M1.6・M1.4)の場合を足す
    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
2026-10-19 M1.4 のねじ1本にかかる力の見積もりを追記
    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
2026-10-19 ねじを M2 にする(フレーム v4.5、モーターマウント v2、機体の案 v2)
    フレームのマウントの穴をφ2.3に、マウントの耳・ナットの穴をM2に合わせ、後ろの耳に
    基板を受ける柱を付けた(マウント v2、1個1.02g)。機体の案 v2 は 52.6g、252 g·cm²。
    注文用の DXF・型紙、3D、ぶつかりの確認、文書を更新した。
    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
    [MK4FRAME45_T1.dxf, MK4PC45_T02.dxf, frame_v4_5.dxf, frame_v4_5_3d.step, mk4_drive_R_check.step, mk4_vehicle_v2.step, motor_mount_L_v1.step, motor_mount_L_v1.stl]
2026-10-19 吸引ファンを渦巻きのケースで囲い、フレームに留める(フレーム v4.6、機体の案 v3)
    ケースをフレームに M2 × 3本で留め、モーターはケースの筒を横のねじで締める。
    基板はケースの柱に載せるだけにした。フレームにケース用の穴を3つ足した(v4.6)。
    機体の案 v3 は 53.9g、265 g·cm²。ファンのまわりの図(fan_view.py)を追加。
    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
    [MK4FRAME46_T1.dxf, MK4PC46_T02.dxf, frame_v4_5_3d.step, frame_v4_6.dxf, frame_v4_6_3d.step, mk4_vehicle_v2.step, mk4_vehicle_v3.step]
2026-10-19 ファンを輪で囲い、3本の腕でモーターを持つ形にする(機体の案 v4)
    輪・腕・ハブ・柱を1つの部品にして、フレームに M2 × 3本で留める。基板のファンの上に
    φ26の穴を開けて上へ吐き出し、電池を5mm後ろへずらした。53.2g、275 g·cm²。
    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
    [mk4_vehicle_v4.step]
2026-10-19 タイヤの穴を前後14mmに広げる(フレーム v4.7)
    角でタイヤとのすき間が0.26mmだったので、穴を13mmから14mmにした(すき間0.50mm)。
    ねじの穴は機体の案 v4 に要る7つ(マウント4、ファンの台3)。強度を計算し直し、注文用の
    DXF・型紙、3D、マウントと機体のぶつかりの確認、文書を更新した。
    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
    [MK4FRAME47_T1.dxf, MK4PC47_T02.dxf, frame_v4_6_3d.step, frame_v4_7.dxf, frame_v4_7_3d.step, mk4_drive_R_check.step, mk4_vehicle_v4.step]
2026-10-19 フレームの見直し: 細くできる所・強くすべき所を計算し、すっきりさせた案 C1・C2 を追加
    部分ごとの働きの図と、部材の幅を1つずつ変えたときの効き(1gあたり)を計算した。
    design.py に後ろ半分だけの幅(*_rear)と、マウントの所の窓をまっすぐ切る pad_full を足した。
    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
2026-10-19 フレームを v5 にする(見直しの C2 + 四角い窓で肉抜き)
    前の外周の枠・骨G・ファンのまわりを太く、後ろ側と吸引する面の中の背骨を細くし、
    マウントの下とタイヤの穴の後ろの横の帯に四角い窓を開けた。5.70g → 5.62g で、
    前の滑り板・前の角・振動・正面と角の座屈が約1割よくなった。注文用の DXF・型紙、3D、
    マウントと機体のぶつかりの確認、文書を更新した。
    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
    [MK4FRAME47_T1.dxf, MK4FRAME50_T1.dxf, MK4PC50_T02.dxf, frame_v4_7_3d.step, frame_v5.dxf, frame_v5_3d.step, mk4_drive_R_check.step, mk4_vehicle_v4.step]
2026-10-19 ファンまわりの図をフレーム v5 で描き直す
    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
2026-10-19 frame v5 と v4.7 の違いの図を足す
    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
2026-10-19 安全率を5まで下げたときの形を計算する(ファンのねじのまわりに窓を開けないようにした)
    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
2026-10-19 フレームを v6 にする(安全率5まで下げてよいとして、作れる一番細い形 T3)
    外周の枠・前後の辺 2.0、骨G・背骨 2.5、筋交いA 1.5、ファンのまわり 2.5mm にし、
    タイヤの穴の前後の横の帯にも窓を開けた。5.62g → 4.61g、機体は 53.1g → 52.1g。
    前の滑り板・前の角のたわみは 1.5 倍、振動数は 274 → 229Hz、材料の安全率は 6.1。
    注文用の DXF・型紙、3D、マウントと機体のぶつかりの確認、文書を更新した。
    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
    [MK4FRAME50_T1.dxf, MK4FRAME60_T1.dxf, MK4PC60_T02.dxf, frame_v5_3d.step, frame_v6.dxf, frame_v6_3d.step, mk4_drive_R_check.step, mk4_vehicle_v4.step]
2026-10-19 frame v6 の筋交いAを 2.0mm に戻す
    1.5mm は加工業者の最小の幅ちょうどで、公差で細くなると困るため。
    カーボン 4.61g → 4.69g、機体 52.1g → 52.2g。注文用の DXF・型紙、3D、
    マウントと機体の確認、文書を更新した。
    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
    [MK4FRAME60_T1.dxf, MK4PC60_T02.dxf, frame_v6.dxf, frame_v6_3d.step, mk4_drive_R_check.step, mk4_vehicle_v4.step]
2026-10-19 機体の重さを筋交いA 2.0mm の値に直す(52.2g)
    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
2026-10-19 ファンと電池は変えないことにし、50gに近づける案を計算し直す
    ねじ(ファンの台をナイロン、マウントをチタン)と印刷の材料(PA12)で 50.5g、
    基板も 0.4mm にして 49.6g。vehicle.py の「もしも」を入れ替え、重さだけの計算
    (FAST=1)でも出すようにした。
    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
2026-10-19 フレームの製作用ファイル(DXF・型紙・3D)を mechanical/frame にまとめる
    注文用の DXF、ポリカーボネートの DXF と型紙、レイヤー別の DXF、3D の STEP を
    mechanical/frame/ に移し、make_order.py・make_dxf.py・frame_3d.py の出力先も
    そこにした。中身は変えていない(作り直して形が同じことを確かめた)。
    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
    [MK4FRAME60_T1.dxf, MK4PC60_T02.dxf, frame_v6.dxf, frame_v6_3d.step]
2026-10-19 フレームを v6.1 にする(前後100 × 左右70mm、ねじの穴を1mm単位に)
    外形を ±50.0 × ±35.0 にし、ねじの穴の中心を車軸から 1mm 単位にした:
    マウント (8, ±22)・(−17, ±22)、ファンの台 (22, ±18)・(33, 0)。穴の間の距離は
    x・y 方向とも整数の mm。モーターマウントも v3 にしてねじの位置を合わせた。
    カーボン 4.66g、材料の安全率 6.3。注文用 DXF・型紙・3D、文書を更新した。
    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
    [MK4FRAME61_T1.dxf, MK4PC61_T02.dxf, frame_v6.dxf, frame_v6_1.dxf, frame_v6_1_3d.step, frame_v6_3d.step, mk4_drive_R_check.step, motor_mount_L_v2.stl]
2026-10-19 機体の案 v4 をフレーム v6.1・マウント v3 で組み直す(52.2g、ぶつかる所なし)
    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
    [mk4_vehicle_v4.step]
2026-10-19 フレームを v6.2 にする(吸引する面を 60 × 30mm、窓のへこんだ角を寸法どおりに)
    吸引する面を ±30 × ±15mm にした。窓の角を丸める処理で、へこんだ角に
    0.05mm ほどの誤差が残り、Fusion で測ると 30.402mm になっていたので、
    出っ張った角だけを丸め、へこんだ角は尖ったまま残すようにした。
    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
    [MK4FRAME62_T1.dxf, MK4PC62_T02.dxf, frame_v6_1.dxf, frame_v6_1_3d.step, frame_v6_2.dxf, frame_v6_2_3d.step, mk4_drive_R_check.step]
2026-10-19 機体の案 v4 をフレーム v6.2 で組み直す(52.2g、ぶつかる所なし)
    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
    [mk4_vehicle_v4.step]
2026-10-19 吸引する面のシートを硬質塩ビ 0.2mm にする(ポリカーボネート 0.2mm から)
    シート 0.45g(+0.06g)、吸引したときのへこみ 0.11mm。フレームの硬さ・強さは
    ほぼ同じ。FEM・型紙・DXF の文字・3D・機体の重さ(52.2g)を更新した。
    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
    [MK4PC62_T02.dxf, frame_v6_2.dxf, frame_v6_2_3d.step]
2026-10-19 DXF の線を直線と本当の円弧で書く(細かい折れ線をやめる)
    丸めた角やファンの穴が細かい折れ線になっていて、CAD で線ががたがたに見えていた。
    dxf_arcs.py で、円に乗る点の並びを LWPOLYLINE の円弧(bulge)に、丸ごと円の
    輪を CIRCLE にした。元の形とのずれは最大 0.008mm。
    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
    [MK4FRAME62_T1.dxf, MK4PC62_T02.dxf, frame_v6_2.dxf]
2026-10-19 壁センサを基板に付け、絵の配置にする(前 (12, ±30)、横 (41, ±24) で交差)
    前の2本は外へ5°で前の壁に72mm、横の2本は反対側の壁へ75°で112mm(柱より手前)。
    基板にセンサの耳と前の角を足した(+0.41g、機体 52.7g)。ぶつかる所なし。
    光の当たる所の図(sensor_view.py)を足した。
    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
    [mk4_vehicle_v4.step]
2026-10-19 基板を U 字にする(絵の形。左右の腕で壁センサへ、ファンの上は開ける)
    後ろは電池の下、左右の腕で前の壁センサの耳 (12, ±30) と前の角 (41, ±24) へ。
    真ん中の前(ファンの上)は開けた。41T の上は |y| ≤ 25 にして、ギアとのすき間を
    0.3 → 1mm 以上にした。機体 52.3g、慣性モーメント 256 g·cm²、ぶつかる所なし。
    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
    [mk4_vehicle_v4.step]
2026-10-19 基板の形の図を、41T の上を狭めた形で描き直す
    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
2026-10-19 滑り板をカグスベール(約1.5mm)にし、段差の強さの計算を文書にする
    滑り板はカグスベール(フリーサイズ)をφ5に切ってフレームの下面に直接貼る
    (床とのすき間 約0.5mm)。加減速で機体は0.64°傾き、反対側は1.0mm上がる。
    スカートの端は床から0.17mmまで下がるが着かない。タイヤ15mmとMK3(24mm)の
    段差を越える力の比較も spec.md に書いた。機体 52.2g、ぶつかる所なし。
    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
    [mk4_vehicle_v4.step]
2026-10-20 通し穴を φ2.2 に、印刷の部品はナットをやめてねじ山を切る(frame v6.3、マウント v4)
    フレーム・基板の通し穴を 2.3 → 2.2(JIS の精級)。モーターマウントとファンの台は
    下穴 φ1.6 に M2 のタップを立て、ナットの穴をなくした(ナットのまわりの 0.7mm の
    薄い壁もなくなる)。マウント 1.02 → 1.14g、機体 52.5g、ぶつかる所なし。
    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
    [MK4FRAME63_T1.dxf, MK4PC63_T02.dxf, frame_v6_2.dxf, frame_v6_3.dxf, frame_v6_3_3d.step, mk4_drive_R_check.step, mk4_vehicle_v4.step, motor_mount_L_v3.step]
2026-10-20 ファンの台をモーターマウントの腕で持つ(マウント v5、frame v6.4)
    ファンの台の左右の柱 (22, ±18) をやめ、モーターマウントの前の耳から腕を伸ばして
    継ぎ目 (10, ±16) で台を持つ(上からナイロンの M2 L6、腕にねじ山)。基板はマウントの
    前後の耳の上の柱で受ける。フレームのねじ穴は 7 → 5。マウント 1.53g、機体 52.2g、
    慣性モーメント 249 g·cm²。ぶつかる所なし(ファンの輪とマウントのすき間 0.94mm)。
    マウントの確認の仮のファン(φ32)を今の輪(φ25.2)に、fan_view.py をねじの数に合わせた。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
    [MK4FRAME64_T1.dxf, MK4PC64_T02.dxf, frame_v6_3.dxf, frame_v6_3_3d.step, frame_v6_4.dxf, frame_v6_4_3d.step, mk4_drive_R_check.step, mk4_vehicle_v4.step]
2026-10-20 吸引ファンを羽根φ32・囲いφ33にし、真下をカーボンで埋める(frame v6.5、マウント v6)
    - フレーム: ファンの円(半径16.5mm)に窓を開けない。吸い込みはφ15だけ。
    カーボン5.18g、前の滑り板0.42mm、261Hz、材料の安全率5.9
    - マウント: ファンの台の継ぎ目を (10, ±16) から (20, ±22) へ。1個1.64g
    - 機体: 羽根φ32、輪の内径φ33、基板のファンの上の穴は半径17.5mm。53.06g、258 g·cm²
    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
    [MK4FRAME65_T1.dxf, MK4PC65_T02.dxf, frame_v6_4.dxf, frame_v6_4_3d.step, frame_v6_5.dxf, frame_v6_5_3d.step, mk4_drive_R_check.step, mk4_vehicle_v4.step]
2026-10-20 ファンの台をフレームに留める前のねじをなくし、輪の壁を1.0mmに(frame v6.6)
    - フレーム: ねじの穴はマウントの4つだけ。ファンの下を埋める半径を17.5mmに。カーボン5.22g
    - ファンの台: マウントの腕 (20, ±22) の2か所だけで持つ。前の腕は輪まで。
    塩ビのない所は輪の下をフレームの上面まで下げる
    - 機体: 53.02g、255 g·cm²、ぶつかりなし
    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
    [MK4FRAME66_T1.dxf, MK4PC66_T02.dxf, frame_v6_5.dxf, frame_v6_5_3d.step, frame_v6_6.dxf, frame_v6_6_3d.step, mk4_drive_R_check.step, mk4_vehicle_v4.step]
2026-10-20 ファンのまわりの断面図を v6.6 に合わせて作り直す
    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
2026-10-20 吸引ファンのモーターを台の筒に圧入する(割りと締めのねじをやめる)
    - 筒の穴φ8.6(寸法どおり)、z 9.4〜16.0 でモーターを6.6mmつかむ
    - 機体 53.04g、255 g·cm²、ぶつかりなし
    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
    [mk4_vehicle_v4.step]
2026-10-20 吸引ファンのモーターの受けを、斜め45°の4本の腕で輪につなぐ
    - ハブと輪を4本の腕で均等につなぎ、輪を枠として使う
    - 輪から継ぎ目 (20, ±22) へ短い腕を出し、モーターマウントの腕に留める(ねじの穴は増やさない)
    - 機体 53.12g、255 g·cm²、ぶつかりなし
    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
    [mk4_vehicle_v4.step]
2026-10-20 簡易計算の出力ファイルを外す
    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
2026-10-21 ファンの台の継ぎ目の上に基板を受ける柱を立てる(前の角の壁センサの揺れを抑える)
    - 継ぎ目 (20, ±22) の上を基板まで柱にし、基板・柱・マウントの腕をナイロンM2 L8でまとめて留める
    - 基板の固有振動: 前の角の壁センサが揺れる振動 169 → 358Hz(pcb_modes.py)
    - 機体 53.29g、256 g·cm²、ぶつかりなし
    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
    [mk4_vehicle_v4.step]
2026-10-21 ファンの台の継ぎ目の上の柱をやめ、ひとつ前の形に戻す(PR #12 を取り消す)
    部品が増えるので、継ぎ目はナイロン M2 L6 で留める元の形に戻す。
    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
    [mk4_vehicle_v4.step]
2026-10-21 ファンの台の継ぎ目を (14, ±22) へ動かし、フレームの窓から見えないようにする(マウント v7)
    - 継ぎ目の台(半径2.5)がフレームのカーボンの上に載る。フレームは変えない
    - マウントの腕は前の耳から前へ6mm。1個1.48g
    - 機体 52.76g、251 g·cm²、ぶつかりなし。真下から見た図を追加
    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
    [mk4_drive_R_check.step, mk4_vehicle_v4.step, motor_mount_L_v6.stl, motor_mount_L_v7.step, motor_mount_L_v7.stl, motor_mount_R_v6.stl, motor_mount_R_v7.step, motor_mount_R_v7.stl]
2026-10-21 モーターマウントの注文メモ(JLC3DP の Temp Resin、M2 は自分でタップ)
    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
2026-10-27 ギア比を今の機体で見直す(41T:13T のまま。gear_study.py)
    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
2026-10-27 吸引ファンの台を部品として書き出す(fan mount v1、STEP・STL)
    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
    [fan_mount_v1.step, fan_mount_v1.stl]
2026-10-27 基板の外形を DXF に書き出す(機体の案 v4 の U 字、参考レイヤー付き)
    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
    [pcb_outline_v4.dxf]
2026-10-28 基板を v5 に広げる(ファンの上を覆い、後ろを x −46 まで。UI の LED 7個)
    - 外形は pcb_shape.py にまとめ、vehicle.py・pcb_dxf.py・pcb_modes.py で共通にする
    - ファンの上はハブとモーターを通す穴(半径7)だけ。前の腕どうしもつなげる。面積 約2,000 → 4,800mm²
    - 機体 55.89g(+3.13g)、慣性モーメント 289 g·cm²、ぶつかりなし
    - 基板の振動: 前の板 165Hz、後ろの板 283Hz
    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
    [mk4_vehicle_v4.step, pcb_outline_v5.dxf]
2026-10-28 電池を1S×3の自作の直列にし、電源の経路と回生・電源を入れた瞬間の跳ね上がりを見積もる
    MK3は1SごとにJST PH(定格2A)でつないでいたので、MK4では電源の経路にPHを使わない。
    回生でVBATは14Vに届かない見込み。危ないのは電源を入れた瞬間の振動なので、
    ゲートのコンデンサでゆっくりONにし、ポリマーのコンデンサで振動を抑える。
    Claude-Session: https://claude.ai/code/session_01H2Zvpqxqu2v63zaiCMmfT3
2026-10-28 電池のコネクタを BT2.0 に決める(XT30 より約1.1g軽く、続けて9A)
    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
2026-10-28 電池は基板の上で直列にする(バランス充電器がないため)
    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
2026-10-29 電池は電池の側で直列にし、BT2.0 1組 + バランス端子にまとめる(バランス充電器を買う)
    基板の上で直列にする形(10-28)から変更。接点が6か所から2か所になり、約1g軽い。
    直列にした電池を多口の1S充電器で充電するとショートするので、その注意も書く。
    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
2026-10-29 電池の電圧はMP6551のVINの近くで測り、11.3Vでソフトが止める。電源を入れた瞬間の対策を決定にする
    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
2026-10-29 基板を v6 に小さくする(前はクワガタ、後ろは x −30 まで)
    - 前は左右の腕の間を x 32 より前で開ける。ファンの上はハブの穴(半径7)だけ開けて覆う
    - 後ろは x −30 まで、後ろの縁に UI の LED 7個。面積 約3,500mm²
    - 機体 54.49g、慣性モーメント 260 g·cm²、ぶつかりなし
    - 基板の振動: 前の角の壁センサ 203Hz(U字のときは169Hz)
    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
    [mk4_vehicle_v4.step, pcb_outline_v6.dxf]
2026-10-29 電源のブロックの回路図を KiCad 9 で作る(電池・電源スイッチ・VBAT・3.3V・電池の電圧)
    - hardware/kicad/KOGUMA-Mk4/: プロジェクト、一番上のシートと電源のシート、
    プロジェクト用の記号(AO4407A、LXDC55FAAA-203、片方向TVS、VBAT)とLXDC55のフットプリント
    - ゲートにコンデンサを付けてもゆっくりONになるよう、スイッチとの間に10kΩを入れ、
    ゲートとソースの間を100kΩにした(spec・bomも直す)
    - DC-DCの入出力のコンデンサの値を決める
    Claude-Session: https://claude.ai/code/session_01H2Zvpqxqu2v63zaiCMmfT3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
    [KOGUMA-Mk4.kicad_sch, power.kicad_sch]
2026-10-29 モーターのブロックの回路図を作り、MP6551 の電流計測(CM)で進めることを決める
    - MP6551 の CM を調べた(精度は typ. のみ、+と−で約25%違う、応答の速さは書かれていない)。
    今の駆動方法(片側の下側のFETをずっと ON)なら電流が常に見えるので、専用ICなしで始め、
    1個ずつ・向きごとに校正する
    - RREF を 6.2kΩ × 2 から 4.7kΩ × 2 に(+側が約4.3Aで振り切れるため)、CM に 1nF
    - motor.kicad_sch: MP6551 × 2(VIN のパスコン、CM、SR、nFAULT、EN)と吸引ファン
    - 記号 MP6551GQB・IRLML6344、フットプリント MPS_QFN-14_2.5x3mm を追加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
    [KOGUMA-Mk4.kicad_sch, motor.kicad_sch, power.kicad_sch]
2026-10-29 MCU のシートを作る(STM32H725RGVx、Direct SMPS、パスコン)
    - mcu.kicad_sch: pinmap.md の41本をグローバルラベルで出す(ネットリストで一致を確認)、
    SMPS は DS13311 の図17「Direct SMPS supply」のとおり(L1 2.2µH、VFBSMPS 10µF、VLXSMPS 220pF)、
    VDD ごとの 100nF + 4.7µF、VBAT 100nF、VDDA はフェライトビーズ + 1µF + 100nF、BOOT0 10kΩ、NRST 100nF
    - VCAP を 2.2µF × 2 から 100nF × 2 に(表15の注1: LDO を使わないとき。VFQFPN68 は Direct SMPS 専用)
    - STM32H725RGVx の記号をプロジェクトに写し、ピンの種類を直す(VLXSMPS を出力、重ねた VCAP を passive)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
    [KOGUMA-Mk4.kicad_sch, mcu.kicad_sch, motor.kicad_sch, power.kicad_sch]
2026-10-29 モーターマウント v8(薄い壁 0.80mm、3点で受ける穴、面取り、軽く)
    - モーターの穴を φ8.6 にし、軸受の穴との間の壁を 0.75 → 0.80mm
    - モーターと軸受の穴は 0.1mm 逃がして当たり面3つで受ける(相手の穴の側に1つ)
    - 穴の入口に面取り 0.3mm、耳と柱の半径 2.6、つなぐ板の幅 3.4mm。1個 1.48 → 1.25g
    - 機体のモデルのマウントも今の mount.py にそろえる。機体 54.02g、257 g·cm²、ぶつかりなし
    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
    [mk4_drive_R_check.step, mk4_vehicle_v4.step, motor_mount_L_v7.step, motor_mount_L_v7.stl, motor_mount_L_v8.step, motor_mount_L_v8.stl, motor_mount_R_v7.step, motor_mount_R_v7.stl]
2026-10-29 水晶(HSE、10MHz)を付ける(MK3 と同じ周波数)
    - mcu.kicad_sch: PH0・PH1 に 10MHz の水晶(3.2 × 2.5mm、4ピン)と負荷容量のコンデンサ 2個
    - pinmap.md・check_pins.py: PH0-OSC_IN・PH1-OSC_OUT を使う(STのピン定義で確かめて OK、使う43本・残り3本)
    - bom.md: 水晶の行を「付けない」から「10MHz」に
    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
    [mcu.kicad_sch, motor.kicad_sch, power.kicad_sch]
2026-10-29 MK3 の回路図を docs/reference に入れ、発振子を MK3 と同じ CSTNE10M0G52Z000R0 にする
    - docs/reference/KOGUMA-CHAN.MkII_v2.pdf: MK3 の回路図(ユーザーから受け取ったもの)
    - mcu.kicad_sch: 水晶 + コンデンサ 2個 を、MK3 と同じ村田のセラミック発振子(10MHz、負荷容量内蔵)に
    - フットプリント Resonator_Murata_CSTNE-3Pin_3.2x1.3mm(村田の仕様書 JGC42-8974A の推奨ランド)
    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
    [mcu.kicad_sch, motor.kicad_sch, power.kicad_sch]
2026-10-29 センサのシートを作る(壁センサ 4ch、IMU、エンコーダの基板への線)
    - sensor.kicad_sch(A3): MK3 の回路(docs/reference)を 3.3V・1個ずつ駆動に合わせて描く。
    発光 OPV332 + NJU6080(20Ω、10mA)× 4、受光 SFH 229 FA + AD8606(820k ∥ 2.2p、PD_BIAS 0.148V)× 4、
    IMU LSM6DSR(SPI3)、エンコーダの基板への6本の線 × 2
    - 発光は MK3 と同じく対角の2個ずつ(MK3 のソフトの WallLED_12 / WallLED_34)。
    ネット名を WALL_LED_L / WALL_LED_R から WALL_LED_FL_R / WALL_LED_L_FR に変える
    - 記号 NJU6080・LSM6DSR を追加。生成に使う記号の継承(extends)と複数ユニットに対応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
    [KOGUMA-Mk4.kicad_sch, mcu.kicad_sch, motor.kicad_sch, power.kicad_sch, sensor.kicad_sch]
2026-10-29 受光のアンプを OPA2354(帰還 0.5pF)に、エンコーダを MT6835 にする
    - 割り込みの周期を極限まで速くしたときのネックを減らすため。受光の回路が一番遅かった
    (AD8606 + 820k ∥ 2.2pF で 1% まで 約8µs)。OPA2354(100MHz)+ 0.5pF C0G で 約1.9µs
    - 発光の定電流 IC は NJU6080 のまま(ON の遅れ 2.5µs。NCR321PAS は PWM 10kHz までで、
    OPV332 には 3.3V で電圧の余裕が足りない)
    - エンコーダ: MT6835(ノイズ 0.0015° rms、遅れ 約10µs、SPI モード3)。校正用の CAL_EN は
    エンコーダの基板のはんだジャンパにし、メイン基板への線は6本のまま
    - オペアンプの電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
    [mcu.kicad_sch, motor.kicad_sch, power.kicad_sch, sensor.kicad_sch]
2026-10-29 spec: 受光のアンプの記述を OPA2354 に合わせる
    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
2026-10-29 表示・入力・通信のシートを作る(LED 7個、ブザー、スイッチ、デバッグの端子)
    - ui.kicad_sch: LED(GPIO H で点灯、1kΩ)、ブザー(2N7002、還流ダイオード)、
    スイッチ(10kΩ プルアップ + 100nF)、デバッグの端子 J7(ToraNeko.Mk3 の J6 と同じ並び、
    STLINK-V3MODS)、UART_RX のテストパッド
    - これで全シートがそろい、ERC のエラーとラベルの相手がいない警告がなくなった
    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
    [KOGUMA-Mk4.kicad_sch, mcu.kicad_sch, motor.kicad_sch, power.kicad_sch, sensor.kicad_sch, ui.kicad_sch]
2026-10-29 エンコーダの基板を作る(MT6835、メイン基板の穴に通してはんだ付け)
    - hardware/kicad/KOGUMA-Mk4_Encoder: 回路図と基板(6 x 12.8 x 0.6mm、2層)。
    MT6835 の中心は下の辺から 4.5mm、部品はすべてチップの面。DRC・ERC エラー 0
    - 線をやめ、メイン基板の穴(ENC_Base_Slot、NPTH 1.0 x 6.6mm)に通して
    上の面でパッド7つをはんだ付けする。マウントの上とメイン基板の間に線を
    通すすき間がないため
    - CAL_EN ははんだジャンパをやめて MCU の PC15(ENC_CAL、左右共通)へ。
    ジャンパはメイン基板の下に隠れて触れないため
    - J5・J6 を7ピンに、pinmap(使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
    [KOGUMA-Mk4_Encoder.kicad_pcb, KOGUMA-Mk4_Encoder.kicad_sch, mcu.kicad_sch, sensor.kicad_sch]
2026-10-29 モーターマウント v9: エンコーダ基板をマウントの面に貼る(ねじなし、裏の壁をなくす)
    - エンコーダ基板を 8.0 × 10.2mm にし、AS5047P の面をマウントの面(y -21.1)に当てて接着する。下はフレーム、前は当たり面で位置決め
    - 貼る所は上の縁・前の縁・下の床。基板の裏は開けて配線を出しやすくする
    - くぼみをモーターの穴とつなげ、v8 まで残っていた 0.2mm の薄い壁をなくす。床は 0.8mm
    - 1個 1.29g。機体 54.17g、258 g·cm²、ぶつかりなし
    Claude-Session: https://claude.ai/code/session_0156Q4g8mrzo4M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
    [mk4_drive_R_check.step, mk4_vehicle_v4.step, motor_mount_L_v8.step, motor_mount_L_v8.stl, motor_mount_L_v9.step, motor_mount_L_v9.stl, motor_mount_R_v8.step, motor_mount_R_v8.stl]
2026-10-29 エンコーダ基板をメイン基板の裏にはんだ付けして立てる(マウント v9 の面は案内)
    - エンコーダ基板 7.8 × 10.3 × 0.6mm(x -2.6〜5.2、z 3.3〜13.6)。マウントの面と 0.1mm、前の当たり面(x 5.4)と 0.2mm、モーターの筒と 0.27mm 離す
    - 基板の DXF に、エンコーダ基板を立てる所(ENC)を足す
    - 機体 54.16g、258 g·cm²、ぶつかりなし
    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
    [mk4_drive_R_check.step, mk4_vehicle_v4.step, motor_mount_L_v9.step, motor_mount_L_v9.stl, motor_mount_R_v9.step, motor_mount_R_v9.stl, pcb_outline_v6.dxf]
2026-10-30 ホイールを書き出す(ToraNeko.Mk3 と同じ形、wheel v1、右・左の STEP・STL)
    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
    [wheel_L_v1.step, wheel_L_v1.stl, wheel_R_v1.step, wheel_R_v1.stl]
2026-10-30 印刷する部品(マウント・ファンの台・ホイール)の材料を JLC Temp Resin にそろえる
    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
2026-10-30 羽根の材料(DMM.make 高精細アクリル)を書く
    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
2026-10-30 機械部品の注文一覧を作る(docs/order.md)
    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
2026-10-30 基板 v7: 形をすっきりさせ、壁センサをホルダに入れる(ToraNeko.Mk3 と同じ形)
    - mechanical/sensor_holder: センサのホルダ v1(CadQuery、STEP・STL)。ToraNeko の
    センサホルダ v4 の STEP を測った寸法(6.0 x 4.04 x 10.5mm、φ3.2 の穴を 3.5・8.1mm、
    3 x 3mm のほぞ)。上に発光 OPV332、下に受光 SFH 229 FA
    - 基板 v7(pcb_shape.py): 後ろは長方形、前はセンサを囲む凸の形をフレームの 1mm 内側で
    切り、車輪の所と前の腕の間だけへこませる。角は R3。ほぞの穴を外形に入れた
    - 壁センサの位置: 前 (12, ±30) → (18, ±29)、横 (41, ±24) → (41, ±18.5)。向きは同じ
    -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
    [mk4_vehicle_v4.step, pcb_outline_v7.dxf, sensor.kicad_sch, sensor_holder_v1.step, sensor_holder_v1.stl]
2026-10-30 ねじを鉄の低頭 M2 L5 の1種類にそろえる(10本)
    - フレームの下からマウントへ4、基板を柱へ4、ファンの台をマウントの腕へ2
    - 機体 55.25g(ねじ +1.09g)、265 g·cm²、ぶつかりなし
    - 注文一覧・部品表・各文書のねじを直す
    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
    [mk4_vehicle_v4.step]
2026-10-30 壁センサのホルダを基板の裏に付ける(ホルダ v2)
    - ホルダを基板の下にさかさまに付ける。ToraNeko と同じ高さ(10.5mm)ではフレームまで
    0.1mm なので、高さ 9.9mm、穴を基板から 3.2(受光)・7.6mm(発光)にした(フレームまで 0.7mm)
    - 光の高さは受光 z 10.4、発光 z 6.0。機体で光を遮る部品がないことを確かめた
    - 機体: 54.88g、重心の高さ z 12.71(13.02 から)、271 g·cm²、ぶつかりなし。基板の1次の振動 169Hz
    - フットプリントの説明を「裏の面に置く」に。外形 v7 はそのまま
    Claude-Session: https://cla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
    [mk4_vehicle_v4.step, sensor.kicad_sch, sensor_holder_v1.step, sensor_holder_v1.stl, sensor_holder_v2.step, sensor_holder_v2.stl]
2026-10-30 基板 v8: フレームと平行な八角形、前は大きな円弧の切り欠き
    - 外形をフレームの 1.5mm 内側の八角形にし、前の切り欠きを円弧(中心 (51, 0)、半径 19)に、
    車輪の所は四角く切る。へこんだ角 R3、出っ張った角 R5(4つの案から選んだ)
    - 横の壁センサを (41, ±18.5) → (40, ±18)。光は横の壁の 67mm 前に当たる
    - 基板の1次の振動 169 → 176Hz、約 3,870mm²
    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
    [pcb_outline_v8.dxf]
2026-10-30 基板 v8 の機体の確認: 55.25g、275 g·cm²、ぶつかりなし
    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
    [mk4_vehicle_v4.step]
2026-10-30 基板 v9: もっと削る(フレームから 3mm、前の円弧を半径 20、後ろの横をまっすぐ)
    - v8 から約 450mm²(−0.5g)減らした。後ろの横は |y| 26.5、前の円弧は x 31 まで
    - 壁センサを削った形に収まる所へ: 前 (18, ±28)、横 (37.5, ±17.5)。光は前の壁 ±34mm、
    横の壁 65mm 前に当たる
    - 基板の1次の振動 176 → 197Hz
    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
    [pcb_outline_v9.dxf]
2026-10-30 基板 v9: 前の壁センサを (21, ±27) へ(マウントの腕・ファンの台の継ぎ目から 1.1mm 離す)
    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
    [pcb_outline_v9.dxf]
2026-10-30 基板 v9 の機体の確認: 54.75g、263 g·cm²、ぶつかりなし
    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
    [mk4_vehicle_v4.step]
2026-10-30 基板 v10: 前の腕(クワガタ)をセンサの所だけ残す角にする
    - 芯(後ろの長方形 + ファンのまわりの半径 14 の円)に、4つの壁センサの所を幅 9mm の首でつなぎ、
    つけ根を R7 で丸める。首の幅は 5・9・12・15mm を比べて 9mm にした
    - 横の壁センサを (37.5, ±17.5) → (37.5, ±14)。光はファンの輪の外側から 8mm、横の壁の 64mm 前に当たる
    - v9 から約 210mm² 減。基板の1次の振動 192Hz(v9 は 196Hz)。v9 の形は outline_v9() に残した
    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
    [pcb_outline_v10.dxf]
2026-10-30 横の壁センサで柱を見る(75° → 64.6°)
    - 区画の中心で、反対側の前の柱の角 (84, ∓84) に光を向ける(道のり 108mm)。
    角を狙えば、前の壁・横の壁があってもなくても柱(の角のまわり)に当たる
    - sensor_view.py: 柱に当たったときは post と書く
    - 基板 v10 の角の形は向きに合わせて少し変わる。1次の振動 195Hz
    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
    [pcb_outline_v10.dxf]
2026-10-30 横の壁センサで柱の中心より前を見る(60.5°)
    - 区画の中心で、反対側の前の柱の前半分の真ん中 (93, ∓84) に光を向ける。前の壁があれば
    前の壁の y ∓68 に当たる
    - sensor_view.py: 前の壁がないときの当たる所を破線で描く
    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
    [pcb_outline_v10.dxf]
2026-10-30 前の壁センサを外へ 10° にする(斜めのとき柱にかかるように、MK3 と同じ)
    - MK3 の斜めの制御(calWallConrol_NANAME)は前センサが柱に近づいたら押し返す。5° だと柱の角の
    線まで 343mm 先で見えないので、MK3(22, ±27、10°)と同じ 10° に。斜めの直線で 171〜232mm 先の
    柱にかかる。前の壁は区画の中心で ±38mm を見る
    - sensor_view.py: 斜めの直線の図(sensor_beams_diag.png)を足した
    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
    [pcb_outline_v10.dxf]
2026-10-30 前の壁センサをフレームの中で一番外 (17, ±30.75) にし、外へ 7° にする
    - 角度が大きいと機体の向きがずれたときの影響が大きいので、なるべく外に置いて角度を小さくした。
    ホルダと足のパッドはフレームの 0.5mm 内側
    - 斜めの直線で FL か FR が柱にかかる割合: 7° で 82%(MK3 の 10° は 76%、6° は 58%)
    - 前の壁は区画の中心で ±39mm を見る。センサの所の基板はフレームの 0.3mm 内側まで
    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
    [pcb_outline_v10.dxf]
2026-10-30 横の壁センサを (42, ±16) に前へ出し、真横から 27.0° にする
    - 区画の中心で柱の中心より前(x 93)を見るのは変えずに、角度を 29.5° → 27.0° に小さくした。
    向きが 1° ずれたときの横の壁の距離の誤差 1.11 → 1.00mm
    - 前の角が長くなり、基板の1次の振動は 136Hz(1G で約 0.013mm)。首を太くしても 146Hz 止まり
    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
    [pcb_outline_v10.dxf]
2026-10-30 基板 v11: 振動対策で前と横の壁センサの間を埋める(1次 136→160Hz)
    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
    [pcb_outline_v11.dxf]
2026-10-30 機体の確認を基板 v11 で: 55.10g、273 g·cm²、ぶつかりなし
    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
    [mk4_vehicle_v4.step]
2026-10-30 基板 v12: 電池の下の窓と、前と横のセンサの間のポケットをくり抜く(−0.85g、1次 145Hz)
    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
    [pcb_outline_v12.dxf]
2026-10-30 機体の確認を基板 v12 で: 54.25g、269 g·cm²、ぶつかりなし
    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
    [mk4_vehicle_v4.step]
2026-10-30 基板 v13: 電池の下はマイコンを置くので窓をやめ、横のポケットだけ(1次 147Hz)
    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
    [pcb_outline_v13.dxf]
2026-10-30 基板 v14: 後ろも削る(電池の下・LED・柱・エンコーダの所だけ残す、−0.44g)
    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
    [pcb_outline_v14.dxf]
2026-10-30 基板 v15: UI の LED を ToraNeko.Mk3 と同じ並びに(後ろを V 字に切り欠く)
    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
    [pcb_outline_v15.dxf]
2026-10-30 基板 v16: へこんだ角 R10・出っ張った角 R3 でなめらかな曲線に
    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
    [pcb_outline_v16.dxf]
2026-10-30 機体の確認を基板 v16 で: 54.40g、265 g·cm²、ぶつかりなし
    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
    [mk4_vehicle_v4.step]
2026-10-30 機体のモデルを main の取り込みのあとで作り直す: 55.49g、272 g·cm²、ぶつかりなし
    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
    [mk4_vehicle_v4.step]
2026-10-31 ぶつかりの確認に、ファンの台・羽根・ファンのモーターと基板の組み合わせを戻す
    古い形(基板をケースの柱に載せていた)の名残で確かめる対象から外していた。
    今の形では触れないので確かめる: ファンの台 - 基板 1.65mm、羽根 - 輪 0.498mm、ぶつかりなし
    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
    [mk4_vehicle_v4.step]
2026-10-31 壁センサのホルダ v3: 下の端をフレームに当てる(両面テープ、足付き)
    - 高さ 9.9 → 10.3mm(下の端 z 3.3)。フレームとの 0.3mm に両面テープ(スポンジ)をはさんで貼る。光の高さは同じ
    - 下の端から後ろへ 3.5mm の足を出し、横の2本もフレームの骨に当てる(カーボンに当たる所 6 → 18mm²)
    - 基板の振動: 横の壁センサが揺れる 148Hz が、ホルダで支えるとなくなる(pcb_modes.py に holders を足す)
    - 機体 55.64g、274 g·cm²、ぶつかりなし
    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
    [mk4_vehicle_v4.step, sensor_holder_v2.step, sensor_holder_v2.stl, sensor_holder_v3.step, sensor_holder_v3.stl]
2026-10-31 印刷する部品の材料: モーターに付く部品は Temp Resin、ホイールと壁センサのホルダは JLC Black Resin
    注文一覧に壁センサのホルダ v3 と両面テープを足す。MJF を使わない理由も書く
    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
2026-10-31 frame v6.7: 壁センサのホルダを当てる所をカーボンで埋める
    - ホルダ v3(足を含む)の真下とまわり 1mm に窓を開けない(design.py の SENSOR_PAD_M・sensor_pads)
    - 4つとも当てる所 45mm² がすべてカーボン。カーボン 5.22 → 5.46g
    - FEM: 前の滑り板 0.41mm、前の角 0.51mm、265Hz、座屈 156/76/510N、材料の安全率 7.2
    - 機体 55.88g、278 g·cm²、ぶつかりなし。注文一覧のフレームのファイルを MK4FRAME67 に
    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
    [MK4FRAME67_T1.dxf, MK4PC67_T02.dxf, frame_v6_6.dxf, frame_v6_6_3d.step, frame_v6_7.dxf, frame_v6_7_3d.step, mk4_vehicle_v4.step]
2026-10-31 frame v6.8: 肉抜き(カーボン 5.46 → 5.17g)
    - 前: 骨G・筋交いA・背骨・吸引の縁 2.5 → 2.0mm。後ろ: 骨G・背骨・外周の枠・後ろの辺 → 1.6mm
    - ホルダを当てる所・ファンの真下は v6.7 のまま埋めてある
    - FEM: 前の滑り板 0.43mm、後ろ 0.46mm、前の角 0.54mm、259Hz、座屈 145/71/508N、安全率 6.9
    - 機体 55.59g、274 g·cm²、ぶつかりなし。注文一覧のフレームを MK4FRAME68 に
    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
    [MK4FRAME68_T1.dxf, MK4PC68_T02.dxf, frame_v6_7.dxf, frame_v6_7_3d.step, frame_v6_8.dxf, frame_v6_8_3d.step, mk4_vehicle_v4.step]
2026-10-31 電池を5mm前へ(中心 x −10 → −5)
    - 重心 x −0.57 → +0.74mm(車軸の前)、慣性モーメント 274 → 263 g·cm²
    - 基板の外形は変わらない(電池は基板の上に全部載る)。基板の DXF の REF の電池の枠を更新
    - 基板の振動(ホルダを当てた形)1次 289 → 292Hz
    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
    [pcb_outline_v16.dxf]
2026-10-31 機体チェック: 電池5mm前でぶつかりなし(電池とマウントの柱 0.79mm)、55.59g、重心 x +0.74mm、263 g·cm²
    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
    [mk4_vehicle_v4.step]
2026-10-31 電池のホルダ v1(左右2個、基板の上のねじ4本を共用)
    - コの字の壁(厚さ1.0、高さ4.0mm、すき間0.3mm)で電池の前後・左右を止める。上下は両面テープ
    - 耳(厚さ1.0mm)を基板のねじ (−17, ±22)・(8, ±22) の頭の下にはさむ。ねじは増やさない(L5 のまま、ねじ山に 3.4mm)
    - Black Resin、1個0.23g。機体 56.07g、重心 x +0.69mm、265 g·cm²
    - 注文一覧・機体・基板の README に追加
    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
    [battery_holder_L_v1.step, battery_holder_L_v1.stl, battery_holder_R_v1.step, battery_holder_R_v1.stl]
2026-10-31 機体チェック: 電池のホルダはぶつかりなし(ねじの頭が耳に当たる、電池との最小 0.22mm)。56.07g、重心 x +0.69mm、265 g·cm²
    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
    [mk4_vehicle_v4.step]
2026-11-01 マウント v10(しまりばめ)、ホルダ v4、エンコーダを ToraNeko と同じ付け方に、frame v6.9、羽根は自分で用意
    - マウント v10: モーターの穴の当たり面 φ8.6 → 8.5、軸受 φ6.0 → 5.9(マイナス公差)
    - 壁センサのホルダ v4: 後ろの足をやめ、基板から 5mm より下を後ろへ 2.2mm 太くしてそのまま下へ。当たる面 37mm²
    - frame v6.9: ホルダ v4 の下の端の真下 + 1mm を窓なし(4つとも 37.4mm² がカーボン)
    - エンコーダ基板 6.0 × 10.3mm をメイン基板の裏に突き当ててはんだ付け(穴に通さない)。基板 v17(ENC_Base_Slot をやめる)
    - 羽根は自分で用意する(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
    [MK4FRAME69_T1.dxf, MK4PC69_T02.dxf, frame_v6_8.dxf, frame_v6_9.dxf, frame_v6_9_3d.step, motor_mount_L_v10.step, motor_mount_L_v10.stl, motor_mount_L_v9.step]
2026-11-01 frame v6.9 の FEM: 5.17g、前 0.43mm、角 0.54mm、259Hz、座屈 145/71/508N、安全率 6.9
    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
2026-11-01 壁センサのホルダ v4 を作り直し: 出っ張りをやめ、角をすべて角にした四角い柱(下の端 6.0 × 4.04mm に緩衝材)。frame v6.9 もそれに合わせた(24.2mm² がカーボン)
    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
    [MK4FRAME69_T1.dxf, MK4PC69_T02.dxf, frame_v6_9.dxf, frame_v6_9_3d.step, sensor_holder_v4.step, sensor_holder_v4.stl]
2026-11-01 マウント v10: 当たり面を 60° 回し、モーターと軸受の間の 0.8mm の壁はしめない(寸法どおり)。frame v6.9 の FEM(安全率 6.8)
    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
    [motor_mount_L_v10.step, motor_mount_L_v10.stl, motor_mount_R_v10.step, motor_mount_R_v10.stl]
2026-11-01 機体チェック: マウント v10・ホルダ v4・frame v6.9・エンコーダ基板(基板の裏に突き当て)でぶつかりなし。56.05g、重心 x +0.68mm、265 g·cm²
    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
    [mk4_vehicle_v4.step]
2026-11-01 マウント v11: エンコーダ基板をマウントの面(y −21.0)に当てる。6.0mm 幅の基板と重なっていた所(x −3.0〜−2.8)を直した。機体の確認でマウントとエンコーダ基板の組も確かめる
    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
    [motor_mount_L_v10.step, motor_mount_L_v10.stl, motor_mount_L_v11.step, motor_mount_L_v11.stl, motor_mount_R_v10.step, motor_mount_R_v10.stl, motor_mount_R_v11.step, motor_mount_R_v11.stl]
